Nicolas233004/Projet_elec4/EcoConception/0.Diapo/ACV_Anti_Varroa_ESP32.pptx

ÉCO-CONCEPTION

Système Anti-Varroa
ESP32

Analyse du Cycle de Vie — ReCiPe 2016 midpoint (H)

🐝

Sean Bondon · Abdoulaye Baldé · Nicolas Roth · Léandro Euphrasie

## Slide 2

01 · CONTEXTE & OBJECTIFS

Problématique & Objectif du Projet

CONTEXTE

Varroa destructor

Acarien parasite — principal fléau mondial des colonies d'abeilles. Effondrement en 2-3 ans sans traitement.

Limites chimiques

Résistances aux acaricides, contamination du miel et de la cire, toxicité pour l'apiculteur.

Hyperthermie

42 °C pendant 2 h — seuil létal du varroa mais supporté par les abeilles. Alternative verte.

🦠

OBJECTIF DU PROJET

Concevoir un dispositif embarqué autonome (ESP32) permettant le traitement thermique anti-varroa, sans produit chimique, utilisable hors-réseau.

⚗️

🎯 Cible thermique

⏱ 2 h / cycle · ≥ 90 % mortalité varroa · 0 produit chimique

42°C

50°C max

🌡️

0°C

## Slide 3

02 · UNITÉ FONCTIONNELLE

Unité Fonctionnelle & Flux de Référence

Éliminer ≥ 90 % des varroas dans une ruche en bois, en maintenant 42 °C pendant 2 h, à raison de 12 traitements/an pour un rucher de 5 ruches, avec un équipement conçu pour durer 5 ans.

42°C

température cible

Seuil létal varroa

2 h

par cycle

Durée traitement

300

cycles / 5 ans

Durée de vie

600 h

chauffe active

Énergie totale

3 axes prioritaires d'éco-conception

Résistance mécanique

≥ 300 manipulations

🔩

Efficience énergétique

600 h de chauffe

⚡

Durée de vie 5 ans

Éviter le renouvellement

♻️

## Slide 4

03 · SCHÉMA BLOC & INVENTAIRE

Architecture ESP32 — Inventaire Ecoconception

DS18B20 ×3

Capteurs T° — OneWire
Pins 15/16/17

Ventilateurs ×2

PWM 200 — Pins 2/4
Régulation airflow

🌡️

ESP32

80 MHz · Wi-Fi AP
FreeRTOS · EEPROM

💨

Résistances ×2

Éléments chauffants
Pins 12/13

Interface Web

AP Wi-Fi SEAN_BONDON
IP 192.168.1.15

🔥

📡

⚠ Sécurité : consigne bornée 10–50 °C · Isolation tâches web / PID via FreeRTOS · Watchdog Wi-Fi (restart si aucun client > 30 s)

## Slide 5

04 · RELEVÉ DES IMPACTS ACV

Résultats ReCiPe 2016 — Points Chauds

Toxicité humaine
non-cancérigène

109,97

kg 1,4-DCB-Eq

Composants électroniques (ESP32, PCB) — métaux lourds

Phase dominante :

Écotoxicité
terrestre

65,11

kg 1,4-DCB-Eq

Extraction minière (Cu, Sn, Au) pour l'électronique

Changement
climatique

14,22

kg CO₂-Eq

Production d'énergie électrique — 600 h de chauffe

#1

#2

#3

Fabrication des composants électroniques > Phase d'utilisation énergétique

→ 18 catégories analysées (OpenLCA) — tableau complet disponible en annexe

## Slide 6

05 · DISCUSSION & AXES D'ÉCO-CONCEPTION

Alternatives & Leviers d'Amélioration

PHYSIQUE

Réduire l'électronique

Simplifier le BOM, composants certifiés EPEAT/TCO, réduire le nombre de PCB — cible l'hotspot principal.

PHYSIQUE

Alimentation solaire

Panneau PV pour la phase d'utilisation (600 h) — réduit l'empreinte CO₂ de la chauffe de ~70 %.

USAGE

Régulation PID

Remplacer le Tout-ou-Rien par un vrai PID : moins de dépassements, durée de chauffe réduite, meilleure efficacité biologique.

📦

☀️

⚙️

PHYSIQUE

Boîtier IP65 modulaire

Résistance humidité/abeilles, remplacement des éléments chauffants seuls, ≥ 300 manipulations garanties.

🔧

USAGE

Fin de vie & DEEE

Prévoir le démontage des cartes, matériaux recyclables pour le boîtier, passeport produit documenté.

♻️

ANALYSE

ACV complète

Ajouter la phase fin de vie + transport. Comparer avec Apivar chimique sur 5 ans pour quantifier le gain.

📊

## Slide 7

CONCLUSION

✓

Projet pertinent

Alternative chimio-free, fonctionnel et autonome

PRIORITÉS D'ACTION

→ Simplifier l'électronique + composants certifiés

→ Alimenter en énergie renouvelable (solaire)

→ ACV complète (fin de vie + transport)

→ Comparer avec traitement chimique Apivar / 5 ans

✓

UF bien définie

300 cycles / 600 h sur 5 ans — périmètre clair

⚠

Phase critique identifiée

Fabrication composants = principal hotspot

⚠

Toxicité dominante

109,97 kg 1,4-DCB-Eq + 65 kg écotox. terrestre

🐝

Questions ?

Méthode : ReCiPe 2016 v1.03 midpoint (H) · Outil : OpenLCA · Système : ESP32 complet
