Nicolas233004/Projet_elec4/EcoConception/0.Diapo/Ecoconception_Varroa_ACV.pptx

Éco-Conception

Système de Chauffage Anti-Varroa
par Hyperthermie

Basé sur ESP32 • Régulation thermique autonome • Apiculture durable

Analyse du Cycle de Vie — Simulation OpenLCA | ReCiPe 2016 v1.03 midpoint (H)

## Slide 2

Plan de la Présentation

Contexte & Problématique

Le Varroa destructor et l'alternative thermique

01

Résultats ACV — Impacts

18 catégories d'impact — ReCiPe 2016

04

Description du Projet

Architecture matérielle et logicielle ESP32

02

Analyse des Points Chauds

Catégories dominantes et leviers

05

Unité Fonctionnelle (UF)

Définition et flux de référence ACV

03

Axes d'Éco-conception

Recommandations et perspectives

06

## Slide 3

Contexte & Problématique

Le Varroa destructor

Acarien parasite de l'abeille mellifère — principale menace mondiale des colonies. Sans traitement, la colonie s'effondre en 2 à 3 ans.

En chiffres

42°C

température cible

Seuil létal du varroa

2h

par traitement

Durée d'un cycle

Les limites des traitements chimiques

Résistance croissante aux acaricides, contamination du miel et de la cire, impact sur la santé des abeilles et de l'apiculteur.

≥ 90%

efficacité visée

Mortalité du varroa

0

produit chimique

Alternative verte

L'alternative : l'hyperthermie

Traiter les abeilles à 42 °C pendant 2 h tue le varroa sans produit chimique, car les abeilles supportent cette température contrairement au parasite.

Objectif : concevoir un dispositif embarqué autonome permettant ce traitement thermique pour un usage en extérieur (hors réseau).

## Slide 4

Description du Projet — Architecture ESP32

Matériel (Hardware)

ESP32 (80 MHz, Wi-Fi AP)

Logiciel (Software)

Tout-ou-Rien ±0,5 °C (PID prévu)

Microcontrôleur

Régulation

3 bus OneWire DS18B20 (Pins 15/16/17)

FreeRTOS — PIDTask sur cœur 1 (50 ms)

Multitâche

Capteurs T°

Consigne sauvegardée EEPROM (défaut 35°C)

2 éléments chauffants (Pins 12/13)

Résistances

Mémoire

Point d'accès Wi-Fi "SEAN_BONDON" — IP fixe 192.168.1.15

Interface Web

2 ventilateurs PWM=200 (Pins 2/4)

Ventilateurs

Redémarrage Wi-Fi si aucun client >30 s

Watchdog réseau

⚠ Limite de sécurité : consigne bornée entre 10 °C et 50 °C — sécurité thermique isolée des tâches web par FreeRTOS

## Slide 5

Unité Fonctionnelle & Flux de Référence

Éliminer ≥ 90 % des varroas dans une ruche Dadant 10 cadres en bois, en maintenant 42 °C pendant 2 h,
à raison de 12 traitements/an pour un rucher de 5 ruches, avec un équipement conçu pour durer 5 ans.

Unité Fonctionnelle :

🎯 Fonction

Éradiquer le varroa par hyperthermie tout en préservant la colonie

⏱ Durée / fréquence

2 h par cycle — 12 traitements/an — 5 ruches

📊 Performance

≥ 90 % de mortalité varroa — maintien continu à 42 °C

3 Axes prioritaires d'éco-conception

📅 Durée de vie

5 ans = 300 cycles = 600 heures de chauffe active

Résistance mécanique

≥ 300 manipulations

Efficience énergétique

600 h de chauffe

Durée de vie 5 ans

Éviter le renouvellement

## Slide 6

Résultats ACV — Impacts par Catégorie (ReCiPe 2016 midpoint H)

Système : Projet complet | Unité : 1 kg | Méthode : ReCiPe 2016 v1.03, midpoint (H)

## Slide 7

Analyse des Points Chauds

Les 3 catégories les plus préoccupantes

Toxicité humaine non-cancérigène

109,97

kg 1,4-DCB-Eq

Valeur dominante. Liée à la production des composants électroniques (ESP32, résistances, PCB) dont la fabrication génère des émissions de métaux lourds et composés organiques.

Écotoxicité terrestre

65,11

kg 1,4-DCB-Eq

Impact principalement associé à l'extraction minière des métaux (cuivre, étain, or) nécessaires à l'électronique embarquée.

Changement climatique

14,22

kg CO2-Eq

Émissions de GES dues à la production d'énergie électrique lors de la phase d'utilisation (600 h de chauffe active sur 5 ans).

Phase dominante : fabrication des composants électroniques > phase d'utilisation énergétique

## Slide 8

Tableau Complet des Impacts — OpenLCA

Catégorie d'impact | Unité de référence | Résultat
Acidification : terrestre | kg SO2-Eq | 0,0694
Changement climatique | kg CO2-Eq | 14,22
Écotoxicité : eau douce | kg 1,4-DCB-Eq | 6,63
Écotoxicité : marine | kg 1,4-DCB-Eq | 8,76
Écotoxicité : terrestre | kg 1,4-DCB-Eq | 65,11
Énergie : non-renouvelable fossile | kg oil-Eq | 3,71
Eutrophisation : eau douce | kg P-Eq | 0,0154
Eutrophisation : marine | kg N-Eq | 1,33×10⁻³
Toxicité humaine : cancérigène | kg 1,4-DCB-Eq | 5,10
Toxicité humaine : non-cancérigène | kg 1,4-DCB-Eq | 109,97 ⚠
Rayonnements ionisants | kBq Co-60-Eq | 1,27
Utilisation des terres | m²·a crop-Eq | 1,07
Ressources : métaux/minéraux | kg Cu-Eq | 0,732
Déplétion de la couche d'ozone | kg CFC-11-Eq | 6,29×10⁻⁶
Formation de particules fines | kg PM2.5-Eq | 0,0338
Formation oxydants photochimiques (santé) | kg NOx-Eq | 0,0450
Formation oxydants photochimiques (éco.) | kg NOx-Eq | 0,0479
Utilisation de l'eau | m³ | 0,110

## Slide 9

Axes d'Éco-Conception & Recommandations

Réduire l'électronique embarquée

Simplifier le BOM (Bill of Materials) : choisir des composants à faible impact de fabrication, opter pour des modules certifiés (EPEAT, TCO). Réduire le nombre de PCB.

01

Fin de vie & circularité

Prévoir le démontage des cartes électroniques pour filière DEEE, choisir des matériaux recyclables pour le boîtier, documenter les matériaux (passeport produit).

04

Optimiser la consommation énergétique

Passage en mode veille profonde entre les cycles, optimisation PID pour éviter les dépassements de 42°C, alimentation solaire envisageable pour usage terrain.

02

Valider le PID thermique

Remplacer la logique Tout-ou-Rien par un véritable PID : évite les dépassements de 42°C, réduit la durée de chauffe et la consommation, améliore l'efficacité biologique.

05

Garantir la durabilité mécanique

Boîtier IP65 résistant à l'humidité/abeilles, composants de qualité industrielle, conception modulaire pour remplacement des éléments chauffants seuls.

03

ACV complète & comparaison

Enrichir le modèle avec la phase de fin de vie et le transport. Comparer avec un traitement chimique Apivar sur 5 ans pour quantifier le gain environnemental.

06

## Slide 10

Conclusion

✓ Projet pertinent

Alternative chimio-free au varroa, fonctionnel et autonome

✓ UF bien définie

300 cycles / 600 h sur 5 ans, 5 ruches — périmètre clair pour ACV

⚠ Phase critique identifiée

Fabrication des composants électroniques = principal hotspot

⚠ Toxicité dominante

109,97 kg 1,4-DCB-Eq (tox. non-cancérigène) et 65 kg (écotox. terrestre)

→ Priorité d'action

Simplifier l'électronique + alimenter en énergie renouvelable

→ Prochaine étape

ACV complète avec fin de vie + comparaison avec traitement chimique

Méthode : ReCiPe 2016 v1.03 midpoint (H) | Outil : OpenLCA | Système : Projet complet ESP32
