Nicolas233004/Projet_elec4/Rapport/0.Groupe/Rapport_Toit_Chauffant_Anti_Varroas.docx

Rapport Technique de Projet

Conception et Réalisation d'un Toit Chauffant

pour Ruche Anti-Varroas

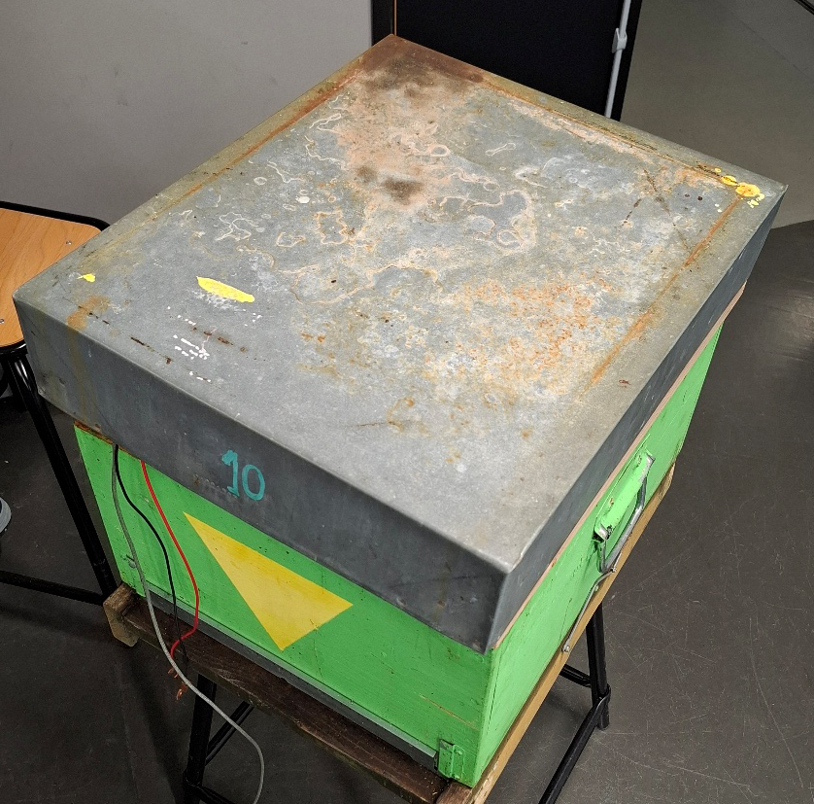
[picture p1: figure]

Équipe Projet | ROTH – EUPHRASIE – BALDE – BONDON
Formation | ELSE 4 – FISA
Période | Octobre 2025 – Avril 2026
Projet n° | 7

# 1. Introduction et Contexte du Projet

## 1.1 Problématique : le Varroa destructor

Le varroa (Varroa destructor) est un acarien parasite originaire d'Asie du Sud-Est qui représente aujourd'hui l'une des menaces les plus sérieuses pour les colonies d'abeilles domestiques à travers le monde. Ce parasite vit aux dépens des abeilles en se fixant sur leur corps et en se nourrissant de leur hémolymphe, affaiblissant ainsi considérablement les individus parasités. Au-delà du prélèvement direct de ressources biologiques, le varroa agit également comme vecteur de nombreux virus pathogènes (virus des ailes déformées, virus de la paralysie aiguë, etc.) qui ont des effets dévastateurs sur les populations apicoles.

Sans traitement, une colonie infestée est condamnée à disparaître en l'espace de 2 à 3 ans. Les méthodes de lutte actuelles incluent les traitements chimiques (acide oxalique, amitraz, fluvalinates), mais ces produits présentent des risques de résistance à long terme, des résidus dans le miel et des effets potentiellement négatifs sur les abeilles elles-mêmes.

Une alternative naturelle et efficace consiste à exploiter la sensibilité thermique différentielle entre les abeilles et les varroas : en portant la température de la ruche à 42°C pendant une durée minimale de 2 heures, il est possible d'éliminer les parasites sans nuire à la colonie. Cette technique, dite de thermothérapie, est l'objet du présent projet.

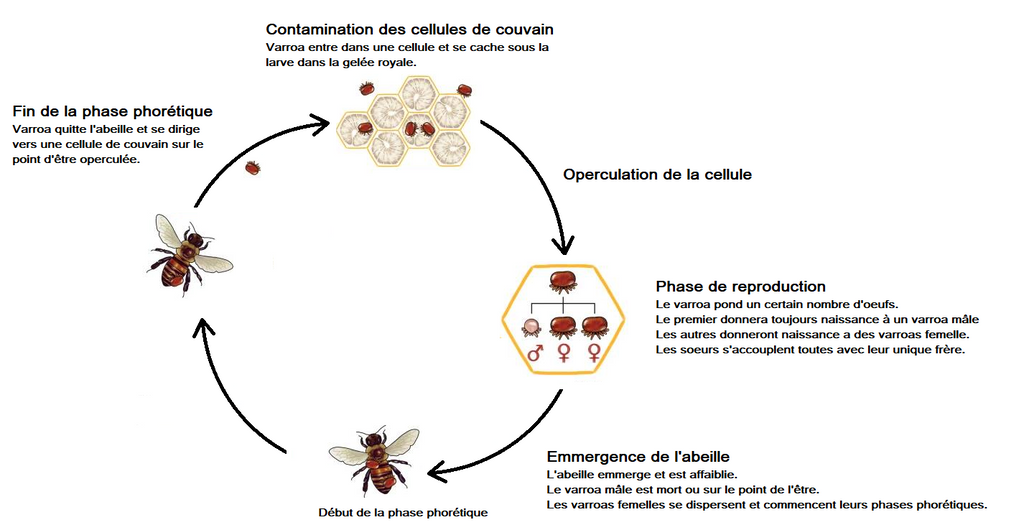
[picture p2: figure]
Varroa, ce que vous DEVEZ savoir. – Apiculture Nicolas D'Amours

## 1.2 Présentation du Projet

Le projet n°7, intitulé « Conception et réalisation d'un toit chauffant pour ruche anti-varroas », s'inscrit dans une initiative plus large visant à développer des ruches connectées capables de se protéger automatiquement des menaces extérieures. L'objectif est de concevoir et réaliser un dispositif électronique embarqué dans le toit d'une ruche, capable de réguler précisément la température interne entre 42°C et 48°C afin d'éliminer les varroas de manière automatique et sans intervention humaine.

Le système repose sur un microcontrôleur ESP32 disposant de deux cœurs de calcul, permettant de gérer simultanément la régulation thermique et l'interface de supervision. Le toit est divisé en deux ailes indépendantes, chacune équipée de résistances chauffantes, de ventilateurs et de capteurs de température, garantissant une homogénéité thermique optimale à l'intérieur de la ruche.

## 1.3 Équipe et Organisation

Le projet a été réalisé par une équipe de quatre étudiants en formation ELSE 4 – FISA, avec une répartition des tâches organisée autour de deux grands domaines :

- Nicolas ROTH – Développement logiciel : code ESP32, régulation, interface web, gestion FreeRTOS.
- Sean BONDON – Partie électronique/mécanique : schémas, PCB, câblage, assemblage de la maquette.
- Leandro EUPHRASIE – Intégration matérielle et écran : soudure, câblage des capteurs, développement de l'afficheur TFT.
- BALD – Conception électronique : schémas sous Eagle, vérification du PCB, simulation sous Micro-Cap.

## 1.4 Cahier des Charges

Les exigences définies en début de projet constituent le cadre de référence de toutes les décisions techniques prises au cours du développement. Elles ont été formalisées dans un CCTP (Cahier des Clauses Techniques Particulières) rédigé dès les premières séances.

Contrainte / Exigence | Description | Statut
Microcontrôleur | Utilisation obligatoire d'un ESP32 | ✔ Respecté
Plage de température | Chauffe entre 42°C et 48°C | ✔ Respecté
Pilotage indépendant | Contrôle des deux ailes du toit de façon autonome | ✔ Respecté
Interface web | Accès à une page de supervision via navigateur | ✔ Respecté
Vérification PCB | Contrôle et refonte si dysfonctionnement | ✔ Effectué
Écran LCD | Affichage local des informations de température | ✔ Réalisé

# 2. Architecture Générale du Système

## 2.1 Vue d'ensemble

Le toit chauffant est un système mécatronique complet intégrant trois grandes dimensions : électronique de puissance, informatique embarquée et interface homme-machine. Son architecture se décompose en deux niveaux physiques superposés dans le toit de la ruche :

- Compartiment inférieur : logement des composants actifs de chauffe et de mesure (résistances, ventilateurs, capteurs DS18B20).
- Compartiment supérieur : logement de la carte de commande à base d'ESP32 et de la carte PCB de puissance.

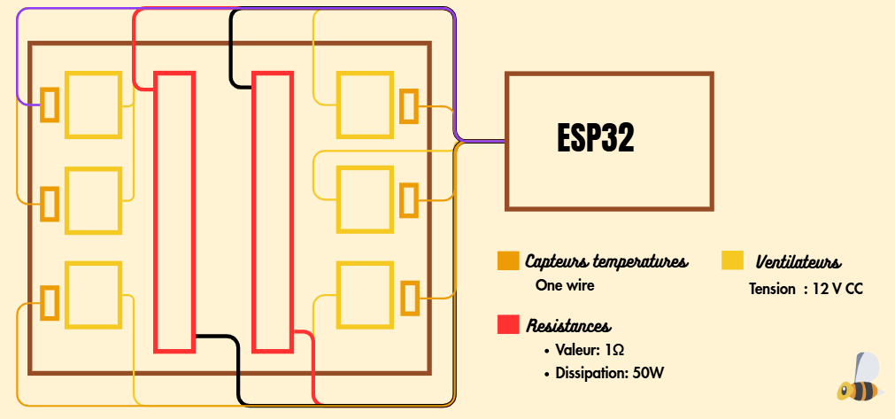
[picture p3: figure]

## 2.2 Architecture Matérielle

### 2.2.1 Le microcontrôleur ESP32

L'ESP32 est un System-on-Chip (SoC) développé par Espressif Systems, doté de deux cœurs Xtensa LX6 cadencés jusqu'à 240 MHz. Pour ce projet, la fréquence a été volontairement abaissée à 80 MHz afin de réduire la consommation de courant et limiter les instabilités d'alimentation. L'ESP32 intègre nativement le Wi-Fi 802.11 b/g/n, le Bluetooth et dispose de nombreuses interfaces périphériques (UART, SPI, I2C, OneWire, PWM, ADC/DAC).

La dualité des cœurs est exploitée via le système d'exploitation temps réel FreeRTOS, permettant d'exécuter simultanément deux tâches indépendantes : la régulation thermique sur le cœur 1 et la gestion du serveur web sur le cœur 0. Cette architecture garantit que les contraintes temps réel de la régulation ne sont pas perturbées par le traitement des requêtes réseau.

Broche ESP32 | Fonction | Composant associé
GPIO 15 (ONE_WIRE_L) | Bus OneWire côté gauche | Capteurs DS18B20 gauche
GPIO 17 (ONE_WIRE_R) | Bus OneWire côté droit | Capteurs DS18B20 droit
GPIO 16 (ONE_WIRE_INFO) | Bus OneWire interne | Capteur intérieur ruche
GPIO 2 (FAN_L) | PWM ventilateur gauche | Ventilateur gauche
GPIO 4 (FAN_R) | PWM ventilateur droit | Ventilateur droit
GPIO 12 (RES_L) | Commande résistance gauche | Résistance chauffante gauche
GPIO 13 (RES_R) | Commande résistance droite | Résistance chauffante droite

### 2.2.2 Capteurs de Température DS18B20

Les capteurs de température utilisés sont des DS18B20 de Dallas Semiconductor, communicant sur un bus OneWire. Ces capteurs à circuit intégré offrent une résolution programmable de 9 à 12 bits, avec une précision de ±0,5°C sur la plage de mesure –10°C à +85°C. Ils sont particulièrement adaptés à ce projet grâce à leur robustesse, leur faible coût et la possibilité d'adresser plusieurs capteurs sur un seul fil de données.

Le projet utilise trois bus OneWire distincts pour isoler les mesures : un pour le côté gauche du toit, un pour le côté droit, et un dédié à la mesure de la température intérieure de la ruche. Cette architecture permet une surveillance indépendante de chaque zone thermique. En cas de défaillance (valeur de –127°C retournée par la bibliothèque), le code déclenche automatiquement une réinitialisation des capteurs pour garantir la continuité de la régulation.

### 2.2.3 Résistances Chauffantes et Ventilateurs

Chaque aile du toit est équipée d'une résistance chauffante alimentée sous 24V (tension nominale de fonctionnement final, après optimisation de l'alimentation). Les résistances sont commandées en ON/OFF par des transistors bipolaires sur la carte PCB. Les ventilateurs, également présents sur chaque aile, assurent la diffusion homogène de la chaleur à l'intérieur du toit, évitant la création de zones thermiques trop importantes.

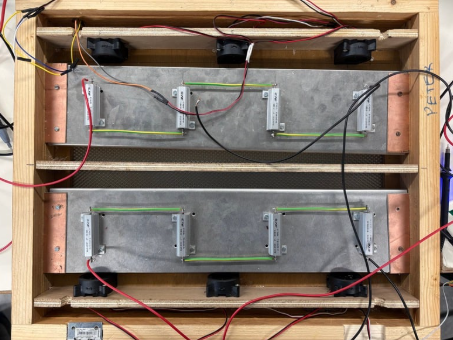
[picture p4: figure]

## 2.3 Architecture Logicielle

### 2.3.1 Organisation du Code Embarqué (ESP32 Principal)

Le firmware de l'ESP32 principal est développé en C++ sous l'environnement PlatformIO (extension Visual Studio Code). Il repose sur les bibliothèques suivantes :

- OneWire + DallasTemperature : communication avec les capteurs DS18B20.
- WiFi + WebServer : gestion du point d'accès Wi-Fi et du serveur HTTP embarqué.
- PID_v1 : algorithme de régulation PID (utilisé en phase initiale de développement).
- EEPROM : sauvegarde persistante de la consigne de température.
- FreeRTOS : système d'exploitation pour la gestion des tâches parallèles.

L'architecture logicielle suit un modèle de concurrence coopérative supervisé par FreeRTOS. La tâche PIDTask, épinglée sur le cœur 1, gère la lecture des capteurs et le contrôle des actionneurs toutes les 500 ms. La boucle principale (loop()), s'exécutant sur le cœur 0, traite les requêtes web toutes les 500 ms également, grâce à un Timer non bloquant.

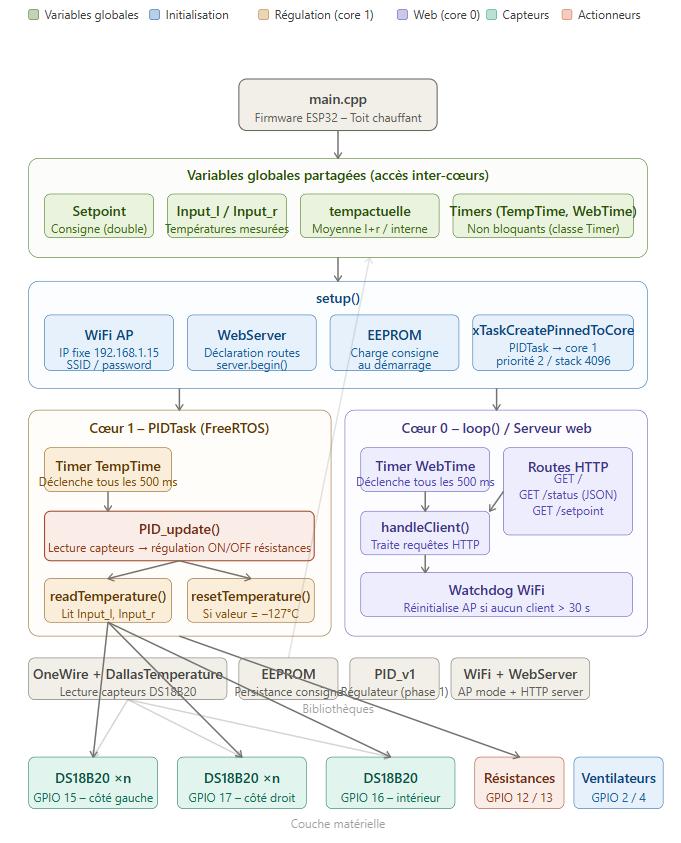
[picture p5: figure]

### 2.3.2 Architecture de l'Écran TFT (ESP32 Secondaire)

Un second ESP32, distinct du module de régulation, est dédié à l'affichage local. Il se connecte en tant que client Wi-Fi au point d'accès créé par l'ESP32 principal et interroge périodiquement la route JSON /status pour récupérer les données de température et de consigne. Ces données sont ensuite affichées sur un écran TFT SPI (contrôleur ST7735, résolution 128×160 pixels) via les bibliothèques TFT_eSPI et ArduinoJson.

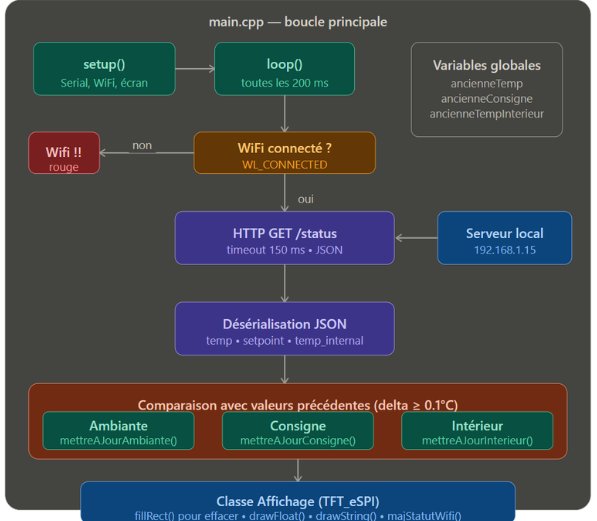
[picture p6: figure]

# 3. Conception et Réalisation du PCB

## 3.1 Analyse du PCB Existant

En début de projet, une carte PCB réalisée par une promotion précédente a été mise à disposition de l'équipe. L'une des premières tâches a consisté à analyser et vérifier le fonctionnement de cette carte avant d'envisager toute modification. Cette analyse a été conduite sous le logiciel Autodesk Eagle, qui a permis de consulter les schémas électriques et d'identifier les différents étages de puissance.

L'examen du PCB a rapidement révélé plusieurs défauts de conception ou d'assemblage hérités de la réalisation précédente : des soudures défectueuses sur les câbles d'alimentation, l'absence de diodes de roue libre sur les circuits de commande des ventilateurs, et des composants (transistors) déjà endommagés lors des premiers tests. Ces problèmes auraient pu provoquer des pannes graves en cas de mise sous tension sans précaution.

## 3.2 Schéma Électronique

Un schéma électrique complet du système a été établi, intégrant les deux ailes indépendantes du toit. Le toit se décompose en deux parties symétriques, chacune comprenant un étage de commande des résistances, un étage de commande des ventilateurs, et le câblage des capteurs de température. La carte PCB gère l'interface de puissance entre l'ESP32 (signaux logiques 3,3V) et les actionneurs (24V pour les résistances, 12V pour les ventilateurs).

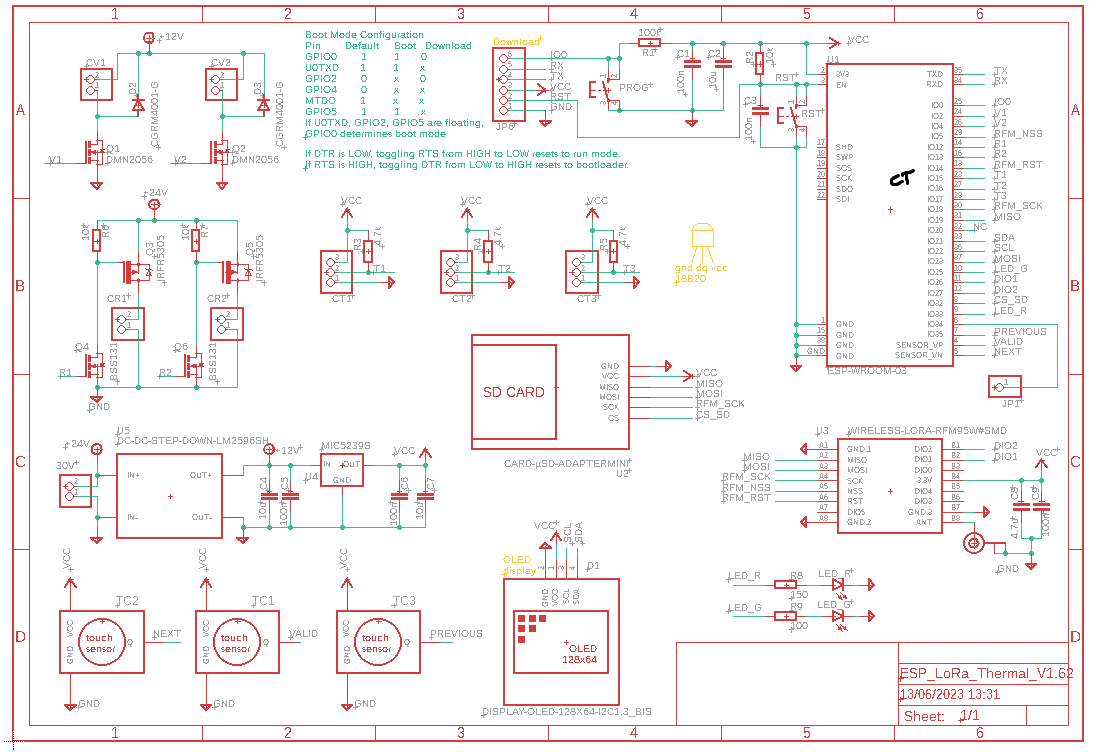
[picture p7: figure]

## 3.3 Composants Critiques et Incidents Matériels

La mise en service du PCB a été jalonnée de nombreux incidents matériels qui ont constitué autant d'occasions d'apprentissage et de diagnostic électronique. Les principaux problèmes rencontrés sont détaillés ci-dessous.

### 3.3.1 Transistors Grillés et Diodes Manquantes

Lors des premiers tests de régulation des ventilateurs par signal PWM, il a été constaté que la commande ne fonctionnait pas correctement. L'analyse à l'oscilloscope a révélé que les transistors bipolaires de commande (en particulier Q3 et Q5) étaient défectueux. La cause principale identifiée était l'absence de diodes de roue libre (ou diodes de protection contre les surtensions inverses) sur les circuits de commande de charges inductives (moteurs de ventilateurs). Sans ces diodes, les pics de tension lors de la commutation (back-EMF) ont détruit les transistors lors des premiers essais.

La solution a consisté à remplacer les transistors défectueux et à souder les diodes de protection manquantes. Un incident supplémentaire s'est produit lors de cette intervention : le pad de soudure de CR1 a été arraché lors du dessoudage. La réparation a été effectuée en connectant directement le fil de remplacement sur une borne accessible du transistor Q3, évitant ainsi de devoir reconcevoir la carte.

INCIDENT CRITIQUE – Court-circuit initial : En séance 4 et 5, un comportement ressemblant à un court-circuit a été détecté. Après analyse, il s'est avéré que les résistances chauffantes consommaient un courant supérieur à la limite réglée sur l'alimentation de laboratoire, provoquant sa mise en protection. Ce n'était donc pas un défaut de la carte, mais un problème de dimensionnement de la source d'alimentation utilisée pour les tests.

### 3.3.2 Composants Q5 et R6 Défectueux

En séance 12, un problème plus grave a été identifié : il était impossible de couper les résistances chauffantes via le code. L'investigation électronique a mis en évidence la défaillance du transistor Q5 et de la résistance R6, éléments-clés du circuit de commande des résistances. Ces composants ont été remplacés, et le montage du convertisseur de tension a été rendu amovible pour faciliter les futures interventions et mesures à l'oscilloscope.

## 3.4 Câblage et Assemblage Mécanique

Le câblage de l'ensemble du système a nécessité un travail minutieux de soudure, de repérage des fils et d'organisation physique des connexions. Les capteurs DS18B20 ont été soudés avec des gaines thermorétractables pour assurer l'isolation électrique et la tenue mécanique des jonctions. Les résistances chauffantes ont nécessité l'allongement de leurs fils de raccordement pour permettre un passage propre entre les deux compartiments du toit.

Des trous ont été percés dans la paroi supérieure du toit au FabLab pour organiser le passage des câbles. Des charnières ont été ajoutées sur la maquette pour faciliter l'accès aux composants lors des interventions, évitant ainsi de devoir dessouder ou débrancher l'ensemble du câblage à chaque ouverture. Enfin, un cache-câbles en bois a été réalisé pour maintenir les fils en ordre et permettre une fermeture propre du toit.

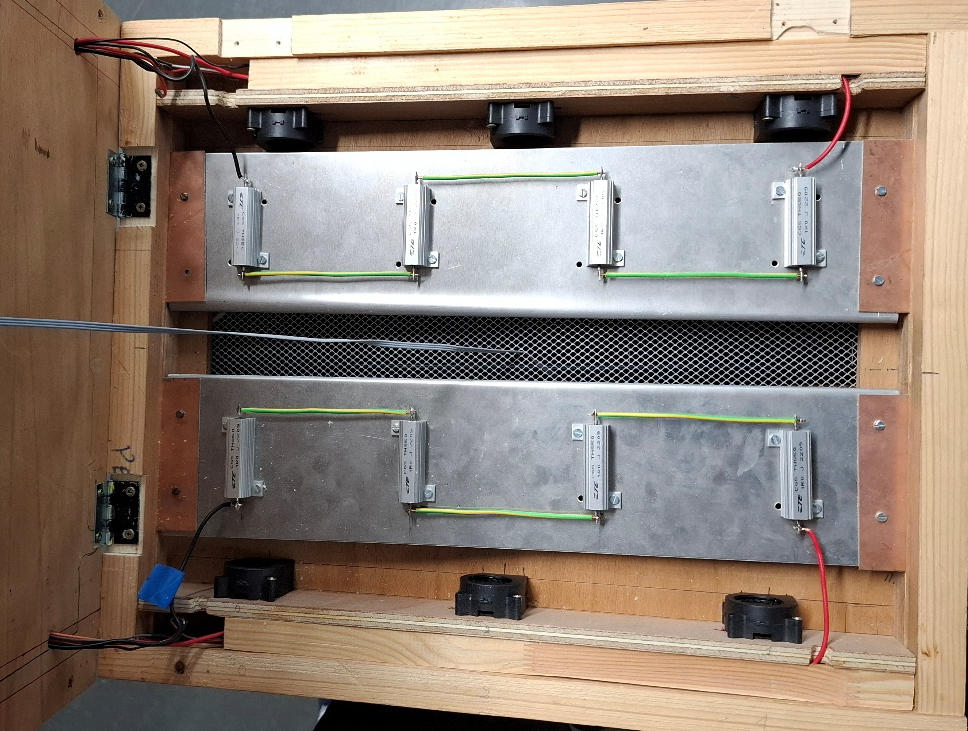
[picture p8: figure]

## 3.5 Simulation sous Micro-Cap 12

En parallèle des travaux matériels, une tentative de simulation du schéma électronique a été réalisée sous le logiciel Micro-Cap 12 (simulateur SPICE). Cette démarche visait à valider le comportement des circuits avant leur mise en œuvre physique. Cependant, les limitations du logiciel (impossibilité d'intégrer certains composants spécifiques comme les moteurs électriques) ont restreint la portée de la simulation, qui a néanmoins permis de vérifier les étages de commande transistorisés.

# 4. Développement Logiciel Embarqué

## 4.1 Environnement de Développement

L'ensemble du développement logiciel a été réalisé sous Visual Studio Code avec l'extension PlatformIO, remplaçant l'IDE Arduino classique. PlatformIO offre une gestion avancée des dépendances de bibliothèques, une meilleure organisation des projets multi-fichiers, et une intégration native avec les outils de compilation pour ESP32. La transition vers cet environnement a nécessité une reconfiguration complète du projet en début de travaux.

## 4.2 Tests Unitaires

Avant l'intégration complète du système, une série de tests unitaires a été réalisée pour valider chaque sous-ensemble indépendamment. Cette approche méthodique, décrite dans le CCTP, a permis d'identifier les défauts matériels au plus tôt et de garantir que chaque composant répondait aux spécifications avant son intégration dans le système global.

Test Unitaire | Objectif | Résultat
1. Pilotage des ventilateurs | Commande PWM indépendante de chaque ventilateur | ✔ Concluant (après réparation transistors)
2. Pilotage des résistances | Commande ON/OFF des résistances chauffantes | ✔ Concluant (après remplacement Q5/R6)
3. Lecture des capteurs DS18B20 | Détection et lecture des 6 capteurs | ✔ Concluant dès la séance 1
4. Pilotage indépendant des ailes | Contrôle séparé côté gauche et côté droit | ✔ Concluant
5. Création page web | Accessibilité du serveur via navigateur | ✔ Concluant
6. Intégration écran LCD/TFT | Affichage température sur écran local | ✔ Concluant (séances 14-15)
7. Assemblage complet | Fonctionnement cohérent de l'ensemble | ✔ Concluant (séance 17)

## 4.3 Algorithme de Régulation Thermique

### 4.3.1 Phase 1 : Régulation PID

Dans un premier temps, une régulation PID (Proportionnelle–Intégrale–Dérivée) a été implémentée à l'aide de la bibliothèque PID_v1. Ce type de régulation permet d'approcher progressivement la consigne sans dépassement excessif (overshoot), grâce au calcul d'une commande basée sur l'erreur courante (terme P), l'accumulation historique des erreurs (terme I) et la vitesse de variation de l'erreur (terme D). L'interface web incluait initialement une page administrateur dédiée au réglage des coefficients Kp, Ki et Kd en temps réel.

### 4.3.2 Phase 2 : Passage à la Régulation Tout-ou-Rien

Face aux problèmes de stabilité de l'ESP32 (resets intempestifs liés à la charge du Wi-Fi et du code), la régulation PID a été temporairement remplacée par une loi de commande tout-ou-rien avec hystérésis. Le principe est simple : si la température mesurée est inférieure à (consigne – 0,5°C), la résistance chauffante est mise sous tension (ON) ; sinon, elle est coupée (OFF). Ce seuil de 0,5°C (défini par la constante SEUIL dans le code) évite les oscillations rapides qui pourraient endommager les actionneurs.

Extrait du code de régulation (fonction PID_update) : if (Input_r < (Setpoint - SEUIL)) digitalWrite(RES_PIN_L, HIGH); else digitalWrite(RES_PIN_L, LOW); if (Input_l < (Setpoint - SEUIL)) digitalWrite(RES_PIN_R, HIGH); else digitalWrite(RES_PIN_R, LOW);

Cette approche, bien que moins précise qu'un PID, s'est révélée plus robuste dans les conditions d'utilisation réelles. La plage de température cible (42°C–48°C) offre une marge suffisante pour qu'une régulation tout-ou-rien soit efficace pour l'application anti-varroa.

## 4.4 Gestion du Multitâche avec FreeRTOS

L'exploitation des deux cœurs de l'ESP32 via FreeRTOS constitue l'une des innovations architecturales majeures du projet. La tâche PIDTask est créée et épinglée sur le cœur 1 avec une priorité de niveau 2, assurant que la régulation thermique est traitée en temps réel sans être interrompue par les activités réseau. Le cœur 0, géré par la boucle Arduino standard, prend en charge le serveur web HTTP.

Les timers non bloquants (classe Timer) permettent de cadencer les différentes activités sans utiliser de delay() bloquants : la lecture des capteurs est effectuée toutes les 500 ms, la gestion des requêtes web toutes les 500 ms également. Un mécanisme de watchdog logiciel surveille la présence de clients connectés au point d'accès ; en l'absence de connexion pendant plus de 30 secondes, le Wi-Fi est réinitialisé automatiquement pour maintenir la disponibilité du service.

## 4.5 Persistance des Données en EEPROM

L'une des améliorations de robustesse apportées en fin de projet concerne la sauvegarde de la consigne de température dans la mémoire EEPROM de l'ESP32. Avant cette modification, tout reset de la carte entraînait la perte de la consigne, forçant l'utilisateur à la ressaisir manuellement. Désormais, la consigne est sauvegardée à chaque modification via la route /setpoint, et rechargée automatiquement au démarrage. Un contrôle de validité (vérification que la valeur est dans la plage 10°C–50°C) permet de détecter une EEPROM non initialisée et d'appliquer la valeur par défaut de 35°C.

## 4.6 Gestion des Erreurs de Capteurs

Un mécanisme de détection et de correction des erreurs de lecture des capteurs DS18B20 a été intégré. Lorsque la bibliothèque DallasTemperature retourne la valeur –127°C (code d'erreur standard OneWire indiquant un problème de communication), la fonction resetTemperature() est appelée automatiquement pour réinitialiser les trois bus OneWire. Cette sécurité est particulièrement importante dans le contexte des resets ESP32, qui peuvent corrompre l'état du bus OneWire et provoquer des lectures erronées persistantes.

# 5. Interface de Supervision

## 5.1 Serveur Web Embarqué

### 5.1.1 Mode Point d'Accès Wi-Fi

L'ESP32 fonctionne en mode Access Point (AP), créant son propre réseau Wi-Fi auquel l'utilisateur peut se connecter directement depuis un smartphone, une tablette ou un ordinateur portable, sans nécessiter d'infrastructure réseau externe (box Internet, routeur). Cette conception rend le système totalement autonome et utilisable sur le terrain, directement au rucher.

Le réseau Wi-Fi est configuré avec l'SSID « SEAN_BONDON » et l'adresse IP fixe 192.168.1.15. La configuration de l'IP fixe (via softAPConfig()) garantit que l'adresse d'accès reste constante, quelle que soit la séquence de démarrage. La directive WiFi.setSleep(false) désactive le mode économie d'énergie du module Wi-Fi, qui était responsable d'instabilités de connexion lors des tests initiaux.

### 5.1.2 Routes HTTP

Le serveur web expose trois routes HTTP accessibles depuis n'importe quel navigateur :

Route | Méthode | Description
GET / | HTTP GET | Retourne la page HTML statique de supervision
GET /status | HTTP GET | Retourne un objet JSON avec les données temps réel
GET /setpoint?value=X | HTTP GET | Modifie la consigne de température (10°C ≤ X ≤ 50°C)

La route /status retourne une structure JSON contenant la température actuelle (moyenne des deux côtés), la température intérieure de la ruche, la consigne en cours, et les valeurs intermédiaires des capteurs et sorties PID. Ces données sont rafraîchies automatiquement toutes les 2 secondes par la page web via une requête fetch() JavaScript asynchrone, permettant un suivi en quasi-temps réel sans rechargement de page.

### 5.1.3 Interface Utilisateur Web

La page web est stockée en mémoire Flash de l'ESP32 (déclarée avec le qualificateur PROGMEM) pour minimiser l'utilisation de la mémoire RAM. Elle présente de manière claire la température de régulation, la température intérieure de la ruche et la consigne actuelle. Un formulaire permet à l'utilisateur de saisir une nouvelle consigne et de l'appliquer immédiatement. Un message de confirmation indique si la modification a été prise en compte avec succès.

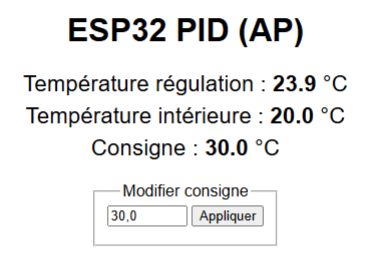
[picture p9: figure]

## 5.2 Afficheur TFT Local

### 5.2.1 Matériel utilisé

Un écran TFT SPI de 128×160 pixels, basé sur le contrôleur ST7735 (remplaçant l'ILI9486 initial perdu lors d'un incident d'alimentation), a été intégré à la maquette. Cet écran est piloté par un second ESP32 dédié, connecté au point d'accès principal. Le choix d'un ESP32 dédié à l'affichage permet de ne pas alourdir le code de régulation et d'éviter les conflits de ressources entre le bus SPI de l'écran et les autres périphériques.

### 5.2.2 Développement de l'Interface

L'interface graphique sur l'écran TFT a été développée en C++ avec la bibliothèque TFT_eSPI. L'interface affiche en temps réel trois informations clés : la température ambiante (mesurée par les capteurs du toit), la température intérieure de la ruche et la consigne de régulation en vigueur. Un code couleur intuitif différencie les informations : la température actuelle s'affiche en orange, la consigne en vert.

Pour éviter les scintillements d'affichage lors des mises à jour, une technique de rafraîchissement sélectif a été implémentée : seules les zones de l'écran contenant des valeurs numériques sont effacées et réécrites, en utilisant la fonction setTextPadding() pour masquer les anciens chiffres sans redessiner entièrement l'écran. La mise à jour n'est déclenchée que si la nouvelle valeur diffère d'au moins 0,1°C de la valeur affichée précédemment (seuil anti-bruit).

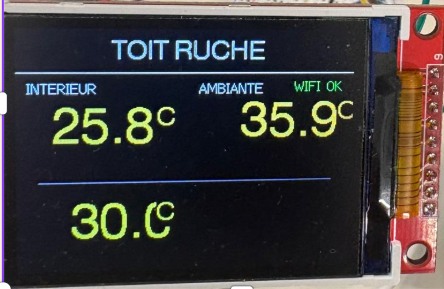
[picture p10: figure]

### 5.2.3 Problèmes Rencontrés et Solutions

L'intégration de l'écran TFT a été l'une des parties les plus complexes du projet, marquée par une succession d'incidents matériels et logiciels.

Le premier écran utilisé (ILI9486) a été détruit lors d'une surtension accidentelle (23V appliqués au lieu des 5V requis lors d'une mauvaise manipulation du générateur de tension en laboratoire). Le second écran (ST7735, 3,3V) a d'abord présenté un écran blanc sans affichage, causé par un branchement incorrect du signal DC sur le GPIO 2 (broche de strapping de l'ESP32, utilisée lors du démarrage). Le déplacement du signal DC vers le GPIO 21 a immédiatement résolu le problème, validant l'ensemble de la chaîne d'affichage.

# 6. Problèmes Rencontrés et Solutions Apportées

La réalisation de ce projet a été marquée par de nombreux obstacles techniques, tant matériels que logiciels. Cette section présente de manière synthétique les principaux problèmes rencontrés, leur diagnostic et les solutions mises en œuvre. La capacité de l'équipe à faire face à ces difficultés de manière méthodique constitue l'un des enseignements majeurs du projet.

## 6.1 Problèmes Matériels

Problème | Cause identifiée | Solution apportée
Tension résiduelle à l'état LOW sur les résistances | Absence de charge lors du test à vide | Test avec charge connectée
Signal PWM non transmis aux résistances | Faux contact sur les câbles de liaison | Dessoudage et ressoudage des fils
Transistors grillés (Q3, Q5) | Absence de diodes de roue libre sur charges inductives | Remplacement transistors + ajout diodes de protection
Pad arraché sur CR1 | Mauvaise qualité de la soudure d'origine | Connexion directe sur borne du transistor Q3
Résistance R6 défectueuse | Composant défaillant | Remplacement de la résistance R6
Écran TFT ILI9486 détruit | Surtension accidentelle (23V) | Remplacement par un écran ST7735 3,3V
Écran blanc (white screen) | Branchement DC sur GPIO 2 (strapping pin) | Déplacement du signal DC sur GPIO 21

## 6.2 Problème Majeur : Reset Intempestifs de l'ESP32

Le problème le plus persistant et le plus difficile à résoudre du projet est apparu lors de l'intégration complète du système : l'ESP32 redémarrait de manière aléatoire, parfois toutes les quelques minutes, rendant le système inutilisable en conditions réelles. Ce problème a mobilisé l'équipe pendant plusieurs séances (séances 9, 13, 14-15 et 16) et a nécessité une approche de débogage progressive.

### 6.2.1 Diagnostic

Plusieurs hypothèses ont été successivement testées pour identifier la cause des resets :

- Watchdog timer (WDT) : déclenchement si une tâche monopolise le CPU trop longtemps sans yield.
- Stack overflow : dépassement de la taille de pile allouée à une tâche FreeRTOS.
- Accès concurrents : deux cœurs accédant simultanément à des données partagées sans protection.
- Consommation de courant : pic de consommation lors de l'activation du Wi-Fi et des résistances dépassant la capacité de l'alimentation.

Après investigation, la cause principale identifiée est la consommation élevée du module Wi-Fi de l'ESP32, provoquant des chutes de tension sur l'alimentation 3,3V qui déclenchent le circuit de reset de la puce. L'ajout d'un condensateur de filtrage plus grand (remplacement de C1) n'a pas suffi à résoudre le problème.

### 6.2.2 Solutions Mises en Œuvre

- Réduction de la fréquence CPU de 240 MHz à 80 MHz (setCpuFrequencyMhz(80)) pour diminuer la consommation globale.
- Désactivation du power-save Wi-Fi (WiFi.setSleep(false)) pour éviter les pics de consommation lors du réveil du module.
- Simplification du code : suppression de la page admin, des paramètres PID réglables, réduction de la mémoire utilisée.
- Passage à une alimentation 24V plus puissante, capable de fournir un courant suffisant pour l'ensemble du système.
- Déplacement de la tâche de régulation sur le cœur 1 pour réduire la charge du cœur 0 (Wi-Fi).
- Sauvegarde de la consigne en EEPROM pour récupérer automatiquement l'état après un reset.
- Ajout d'un mécanisme de réinitialisation automatique du Wi-Fi après 30 secondes sans client connecté.

Résultat : Ces mesures cumulées ont significativement réduit la fréquence des resets, rendant le système suffisamment stable pour une démonstration fonctionnelle. Cependant, une solution définitive (alimentation dédiée à l'ESP32 séparée de la puissance des résistances) reste à mettre en œuvre pour un déploiement réel.

## 6.3 Problèmes Logiciels

Problème logiciel | Cause | Solution
Bibliothèques manquantes après suppression accidentelle | Fichiers essentiels effacés | Réinstallation complète des bibliothèques PlatformIO
Migration Arduino IDE → PlatformIO | Incompatibilité de configuration | Reconfiguration complète du projet
Consigne perdue après reset | Stockage uniquement en RAM | Sauvegarde/chargement en EEPROM
Lecture capteur –127°C persistante | Bus OneWire corrompu après reset | Réinitialisation automatique des capteurs si –127 détecté
Scintillement de l'écran TFT | Rafraîchissement complet de l'écran | Rafraîchissement sélectif avec setTextPadding()

# 7. Tests, Validation et Résultats

## 7.1 Tests de l'Interface de Supervision

L'interface web a été testée depuis différents terminaux (smartphones Android et iOS, ordinateurs portables) pour valider sa compatibilité navigateur et sa réactivité. Le rafraîchissement automatique des données toutes les 2 secondes a été vérifié, ainsi que la prise en compte des modifications de consigne. La persistance de la consigne après reset a également été vérifiée : en coupant et rallumant l'alimentation de l'ESP32, la consigne précédemment saisie est bien restaurée.

L'afficheur TFT a été validé en conditions opérationnelles, connecté au point d'accès de l'ESP32 principal à une distance de plusieurs mètres. Les températures affichées correspondent aux valeurs de référence mesurées indépendamment. Le temps de latence entre la mesure physique et l'affichage sur l'écran est inférieur à 1 seconde dans des conditions de connexion Wi-Fi normales.

## 7.2 Bilan de Conformité au CCTP

Exigence CCTP | Résultat obtenu | Conformité
Pilotage ventilateurs indépendant | Ventilateurs gauche et droit commandés séparément via PWM | ✔ Conforme
Pilotage résistances indépendant | Résistances ON/OFF indépendantes par aile | ✔ Conforme
Lecture capteurs température | 6 capteurs DS18B20 + 1 interne lus correctement | ✔ Conforme
Régulation entre 42°C et 48°C | Consigne configurable, régulation ON/OFF avec seuil 0,5°C | ✔ Conforme
Accès interface web | Page web accessible à 192.168.1.15 | ✔ Conforme
Écran LCD/TFT | Afficheur TFT 128×160 opérationnel | ✔ Conforme
Deux cœurs ESP32 | Régulation sur core 1, Web sur core 0 via FreeRTOS | ✔ Conforme
Stabilité (reset) | Atténuée mais non totalement résolue | ⚠ Partiel

# 8. Retour d'Expérience et Perspectives

## 8.1 Compétences Développées

Ce projet a permis aux membres de l'équipe de développer et approfondir un large spectre de compétences, aussi bien techniques que transversales.

### 8.1.1 Compétences Techniques

- Programmation C++ embarquée : développement sous PlatformIO, gestion des bibliothèques, architecture multi-tâches avec FreeRTOS.
- Électronique de puissance : dimensionnement des circuits de commande, diagnostic et réparation de composants défectueux (transistors, diodes, résistances).
- Soudure et câblage : techniques de soudure fine sur PCB, utilisation des gaines thermorétractables, organisation du câblage dans un espace contraint.
- Communication sans fil : configuration du mode AP Wi-Fi sur ESP32, développement d'un serveur HTTP embarqué, protocole JSON pour l'échange de données.
- Interfaces homme-machine : développement d'une page web responsive, programmation d'un afficheur TFT via SPI.
- Débogage système : utilisation de l'oscilloscope, du multimètre, des logs série pour identifier et corriger des pannes complexes.

### 8.1.2 Compétences Transversales

- Gestion de projet : planification des tâches, adaptation en cas de blocage, travail en parallèle sur différents sous-systèmes.
- Documentation technique : rédaction de rapports de séance, maintien d'un historique des incidents et des solutions.
- Travail en équipe : répartition des rôles selon les compétences, entraide (formation à la soudure, débogage collaboratif).
- Utilisation du FabLab : perçage, découpe bois, accès aux équipements de prototypage.

## 8.2 Points d'Amélioration Identifiés

Avec le recul du projet, plusieurs axes d'amélioration ont été identifiés pour une version future du système :

### 8.2.1 Alimentation

Le problème de reset de l'ESP32 lié à l'alimentation est le point critique à résoudre en priorité. La solution recommandée est la mise en place d'une alimentation dédiée et régulée pour l'ESP32 (3,3V avec condensateur de découplage suffisant), totalement indépendante de l'alimentation des résistances chauffantes (24V). Un régulateur à faible bruit (LDO) ou un convertisseur DC-DC bien filtré permettrait d'isoler les perturbations induites par la commutation des résistances.

### 8.2.2 Régulation PID

La régulation tout-ou-rien actuelle, bien que fonctionnelle pour l'objectif anti-varroa, pourrait être améliorée par la réintroduction d'un PID correctement ajusté une fois le problème d'alimentation résolu. Un PID permettrait une montée en température plus rapide et un maintien plus précis de la consigne, réduisant les oscillations thermiques autour du point de consigne.

### 8.2.3 Interface et Fonctionnalités

- Ajout d'un chronomètre pour mesurer la durée du traitement thermique (minimum 2h requis pour éliminer les varroas).
- Notification automatique (e-mail ou SMS via module GSM) lorsque le traitement est terminé.
- Historisation des températures avec horodatage pour tracer des courbes de chauffe et valider l'efficacité du traitement.
- Réintégration de la page administrateur avec réglage des paramètres PID pour les utilisateurs avancés.
- Ajout d'un boîtier de protection IP54 pour résister aux conditions extérieures du rucher.

## 8.3 Conclusion Générale

Ce projet universitaire de 17 séances a abouti à la réalisation d'un prototype fonctionnel de toit chauffant anti-varroa pour ruche d'abeilles. L'ensemble des exigences du CCTP a été satisfait, à l'exception d'une stabilité électrique parfaite qui nécessiterait une révision de l'architecture d'alimentation.

Le système démontre la faisabilité technique d'une solution de thermothérapie automatisée, autonome et supervisable à distance, accessible à un apiculteur disposant d'un smartphone. L'intégration d'un microcontrôleur ESP32 avec ses deux cœurs, d'une interface web embarquée et d'un afficheur local constitue une architecture solide qui pourrait, après correction des points de fragilité identifiés, être déployée en conditions réelles.

Au-delà des résultats techniques, ce projet a représenté une expérience d'apprentissage riche pour tous les membres de l'équipe, confrontés à des problèmes concrets de conception électronique, de programmation embarquée et de gestion de projet en contexte réel.

# 9. Annexes

## Annexe A – Chronologie du Projet

Séance | Date | Thème principal | Acteurs
1 | 08/10/2025 | Mise en place environnement, tests capteurs DS18B20 | Nicolas
2 | 23/10/2025 | Tests résistances et ventilateurs, code principal + PID | Nicolas / Roth
3 | 10/10/2025 | Développement page web embarquée | Nicolas
4 | 11/10/2025 | Amélioration web (user/admin), court-circuit détecté | Nicolas
5 | 27/11/2025 | Analyse court-circuit, tests PWM, dessoudage/ressoudage | Nicolas / Sean
6 | 28/11/2025 | Tests côté gauche, transistor grillé identifié | Sean / Nicolas
7 | 11/11/2025 | Remplacement transistors + diodes, validation côté gauche | Roth / Sean
8 | – | Schéma électrique, PCB Eagle, câblage résistances | Sean / Leandro
9 | 21/01/2026 | Mode Access Point Wi-Fi, répartition sur 2 cœurs | Nicolas
10 | 03/02/2026 | Début intégration écran TFT ILI9486 | Nicolas / Leandro
11 | 17/02/2026 | Charnières maquette, débogage carte, tests écran | Toute l'équipe
12 | 19/02/2026 | Remplacement Q5/R6, validation contrôle résistances | Nicolas / Sean
13 | 05/03/2026 | Tests globaux maquette, reset ESP32 identifié | Toute l'équipe
14-15 | 17/03/2026 | Stabilisation alimentation, Wi-Fi, simplification code | Nicolas / Leandro
16 | 03/04/2026 | Alimentation 24V, régulation ON/OFF, capteur interne | Toute l'équipe
17 | 10/04/2026 | Finalisation maquette, EEPROM, tests globaux complets | Toute l'équipe

## Annexe B – Bibliothèques Utilisées

Bibliothèque | Version | Rôle
OneWire | – | Communication bus OneWire pour DS18B20
DallasTemperature | – | Lecture des capteurs DS18B20
WiFi (ESP32) | – | Gestion du réseau Wi-Fi en mode AP
WebServer (ESP32) | – | Serveur HTTP embarqué
PID_v1 | – | Algorithme de régulation PID (phase 1)
EEPROM (ESP32) | – | Sauvegarde persistante de la consigne
FreeRTOS | – | Gestion multitâche sur les deux cœurs
TFT_eSPI | – | Pilotage écran TFT SPI ST7735
ArduinoJson | – | Parsing des données JSON sur l'ESP32 écran
HTTPClient (ESP32) | – | Requêtes HTTP client depuis l'ESP32 écran

## Annexe C – Glossaire

Terme | Définition
ESP32 | Microcontrôleur dual-core Wi-Fi/Bluetooth d'Espressif Systems
DS18B20 | Capteur de température numérique sur bus OneWire de Dallas Semiconductor
PWM | Pulse Width Modulation – modulation de largeur d'impulsion pour contrôle de puissance
PID | Proportionnel–Intégral–Dérivé – algorithme de régulation classique en boucle fermée
FreeRTOS | Système d'exploitation temps réel open source pour microcontrôleurs
OneWire | Protocole de communication série sur un seul fil de données
PCB | Printed Circuit Board – carte de circuit imprimé
AP | Access Point – mode Wi-Fi où l'ESP32 crée son propre réseau
EEPROM | Electrically Erasable Programmable ROM – mémoire non volatile reprogrammable
TFT | Thin-Film Transistor – technologie d'écran à cristaux liquides
SPI | Serial Peripheral Interface – bus de communication série synchrone
JSON | JavaScript Object Notation – format léger d'échange de données
Varroa | Varroa destructor – acarien parasite des abeilles domestiques
CCTP | Cahier des Clauses Techniques Particulières – document de spécifications techniques
EEPROM | Mémoire persistante de l'ESP32 utilisée pour sauvegarder la consigne

ROTH – EUPHRASIE – BALDE – BONDON | 1 / 2

Rapport Projet – Toit Chauffant Anti-Varroas | ELSE 4 FISA
