Nicolas233004/Projet_elec4/Rapport/Rapports Abdoulaye/Rapport Séance 13.md

# Rapport de Séance - Abdoulaye Baldé
## Date : 17 mars 2026

Je n'ai pas pu assister aux travaux pratiques du 17 mars 2026 (matin et après-midi) pour des raisons médicales. J'ai informé le professeur et transmis un justificatif à la scolarité.

---

*Abdoulaye Baldé
