Nicolas233004/Projet_elec4/Rapport/Rapports Abdoulaye/Rapport séance 14.md

# Rapport de Séance Personnelle - Abdoulaye
## Date : 3 avril 2026

## Contexte
Séance de reprise après deux absences pour raison médicale. Durant mon absence, les autres membres de l'équipe ont finalisé les corrections matérielles (court-circuit, chute de tension, remplacement de condensateurs et d'un capteur) et ont intégré la partie logicielle dont j'étais responsable. Le système semble désormais fonctionnel.

## Travail effectué

### Constat et état d'avancement
- Les problèmes de la carte ont été résolus par l'équipe.
- Les tests préliminaires indiquent que l'ensemble fonctionne correctement.

### Mes actions personnelles
- J'ai pris connaissance des modifications apportées par l'équipe.
- J'ai exploré l'utilisation de Wokwi en simulation pour tester indépendamment la logique dual-core (LEDs, capteurs virtuels). Cette approche m'a permis de valider le comportement attendu du code en l'absence de matériel.

### Bilan personnel
Bien que je n'aie pas pu participer à la phase finale d'intégration en raison de mon absence, l'essentiel de mon travail (architecture dual-core, gestion des seuils, synchronisation) est présent dans la solution finale. Cette situation me montre l'importance de la continuité dans un projet d'équipe et me motive à rattraper le retard sur les aspects que j'aurais pu approfondir (simulation, documentation).

## Prochaines étapes
- Finaliser ma prise en main des modifications apportées.
- Contribuer à la documentation finale et aux tests de validation.
- Poursuivre l'apprentissage de Wokwi pour les futurs développements.

---

*Abdoulaye Baldé
