Nicolas233004/Projet_elec4/Rapport/Rapports Abdoulaye/Rapport Séance 11.md

# Rapport de Séance Personnelle - Abdoulaye
## Date : 19 février 2026

## Contexte
Cette séance s'est déroulée dans une période d'attente technique, les autres membres du groupe étant encore en train de finaliser les vérifications matérielles suite au remplacement du transistor défaillant. La carte n'était donc pas disponible pour les tests pratiques.

## Déroulement de la Séance

### Revue et Optimisation du Code
J'ai consacré cette séance à une révision approfondie du code dual-core en prévision des prochains tests :

- **Vérification de la cohérence globale** du programme
- **Optimisation des commentaires** pour une meilleure maintenabilité
- **Préparation des modifications** à apporter en fonction des premiers retours matériels

Cette phase de revue, bien que moins visible qu'un test réussi, est essentielle pour garantir la robustesse du code lors de la mise en situation réelle.

### Anticipation des Prochains Tests
J'ai également profité de cette séance pour :
- Lister les points de vérification prioritaires
- Préparer un protocole de test étape par étape
- Identifier les seuils critiques à surveiller

## Problèmes Rencontrés
- **Indisponibilité de la carte** pour les tests pratiques
- **Attente** de la validation matérielle complète par les autres membres

## Acquis de la Séance
- Renforcement de la compréhension globale du code
- Amélioration de la documentation technique
- Préparation méthodique des futures phases de test

## Prochaines Étapes
1. Passage aux tests pratiques dès que le matériel sera disponible
2. Validation du bon fonctionnement des capteurs côté A et B
3. Test de la régulation dual-core en conditions réelles
4. Ajustements du code si nécessaire

---

*Abdoulaye Baldé*
