Nicolas233004/Projet_elec4/Rapport/Rapports Abdoulaye/Rapport Séance 10.md

# Rapport de Séance Personnelle - Abdoulaye
## Date : 17 février 2026

## Contexte
Cette séance devait être consacrée aux premiers tests pratiques du code dual-core sur la carte, mais les problèmes matériels persistent. Un transistor défaillant a été identifié et son remplacement était en cours par les autres membres du groupe. D'autres tests matériels étaient également réalisés en parallèle par l'équipe.

## Déroulement de la Séance

### Révision Approfondie du Code
En attendant la résolution des problèmes matériels et la disponibilité de la carte, j'ai consacré cette séance à une revue complète et méthodique du code dual-core :

- **Vérification de la logique de synchronisation** entre les deux cœurs (variables partagées et drapeau)
- **Optimisation des temporisations** pour garantir une réactivité optimale
- **Validation des seuils de déclenchement** pour les résistances et ventilateurs
- **Ajout de commentaires détaillés** pour faciliter la maintenance future
- **Préparation de scénarios de test** pour valider chaque fonctionnalité dès que le matériel sera disponible

### Anticipation des Tests à Venir
J'ai également préparé un plan de test détaillé pour la prochaine séance, incluant :
- Les vérifications à effectuer sur chaque capteur individuellement
- Les séquences de test pour valider le contrôle des actionneurs
- Les points critiques à surveiller lors du premier démarrage

## Prochaines Étapes
1. **Finalisation des réparations matérielles** (transistor et autres composants)
2. **Tests intensifs du code dual-core** dès que la carte sera opérationnelle
3. **Ajustements** basés sur les résultats des tests
4. **Intégration progressive** des fonctionnalités supplémentaires

---

*Abdoulaye Baldé*
