Nicolas233004/Projet_elec4/Rapport/Rapports Abdoulaye/Rapport Séance 9.md

# Rapport de Séance Personnelle - Abdoulaye
## Date : 3 février 2026

## Contexte
Séance consacrée au diagnostic et à la résolution des problèmes de court-circuit persistants sur la carte électronique, qui bloquent l'avancement des tests logiciels depuis plusieurs semaines.

## Déroulement de la Séance

### Investigations Matérielles Approfondies
Nous avons poursuivi les investigations en utilisant une approche systématique avec deux outils principaux :

- **Multimètre** : pour les tests de continuité, mesures de résistance et vérification des tensions
- **Oscilloscope** : pour analyser les signaux et détecter d'éventuelles anomalies dynamiques

### Résultats des Diagnostics
Grâce à cette méthodologie, nous avons réussi à réduire le problème de court-circuit de moitié. Cependant, la localisation précise reste complexe car :

- Le problème semble se déplacer selon les composants testés
- Certains composants présentent des intermittences dans leur comportement
- Les défauts apparaissent et disparaissent selon les conditions de test

### Travail Collaboratif
J'ai participé activement aux sessions de débogage en alternant entre :
- La manipulation des instruments de mesure
- L'analyse des résultats obtenus
- La discussion des hypothèses avec l'équipe

## Problèmes Rencontrés

### Nature Fluctuante du Problème
- **Localisation changeante** : le défaut semble se manifester sur différents composants à différents moments
- **Intermittence** : le court-circuit apparaît et disparaît, compliquant la répétabilité des tests
- **Complexité du circuit** : la densité des composants rend l'isolation du problème difficile

### Impact sur le Développement
- Impossibilité de procéder aux tests du code dual-core
- Retard significatif dans le calendrier de validation
- Frustration liée à l'incapacité de valider les avancées logicielles

## Prochaines Étapes

### Priorités Immédiates
1. Finaliser l'isolation complète du ou des court-circuits résiduels
2. Remplacer les composants identifiés comme défectueux
3. Procéder à une validation complète de la carte après réparations

### Planification
- Poursuite des investigations lors de la prochaine séance
- Préparation d'un plan de test complet pour valider la stabilité matérielle
- Coordination avec toute l'équipe pour une résolution définitive

## Bilan Personnel
Cette séance a été techniquement exigeante mais formative. Bien que frustré par la persistance des problèmes matériels, je reconnais la valeur des compétences acquises en diagnostic électronique. La réduction du problème de moitié représente un progrès tangible, même s'il reste insuffisant pour reprendre les tests logiciels.
