Nicolas233004/Projet_elec4/Rapport/Rapports Abdoulaye/Rapport Séance 8.md

# Rapport de Séance Personnelle - Abdoulaye
## Date : 21 janvier 2026

## Contexte
Cette séance particulière a été divisée en deux temps : une première partie consacrée aux présentations orales de l'état d'avancement de chaque groupe, suivie d'une reprise normale des travaux de développement.

## Déroulement de la Séance

### Présentation Orale
J'ai présenté à l'ensemble de la promotion notre avancement sur la programmation dual-core de l'ESP32. J'ai notamment présenté :

- L'architecture dual-core exploitant les deux cœurs de l'ESP32
- Le diagramme de flux illustrant la répartition des tâches
- Les avantages concrets en termes de performance et de robustesse
- Les perspectives d'évolution avec l'intégration du contrôle PID

Les retours ont été positifs et ont confirmé la pertinence de notre approche technique.

### Reprise des Travaux
Après la session de présentation, nous avons repris le développement normal du projet. Mon travail s'est concentré sur :

- **Révision approfondie du code dual-core** : vérification de la synchronisation entre les cœurs, optimisation des temporisations, validation de la logique de contrôle
- **Documentation technique** : mise à jour des commentaires et de la documentation du code pour faciliter la maintenance future

## Problèmes Rencontrés
Malgré l'avancement logiciel, les tests pratiques restent impossibles en raison de :

- **Problèmes matériels persistants** sur la carte électronique
- **Indisponibilité du banc de test** complet pour valider l'intégration
- **Dépendance aux corrections** des autres autres membres sur les aspects matériels

## Acquis de la Séance
- Compétences en communication technique
- Expérience en revue de code et optimisation
- Patience et adaptation face aux contraintes matérielles

## Prochaines Étapes
1. Poursuite des corrections matérielles 
2. Tests immédiats dès que le matériel sera disponible

## Bilan Personnel
Cette séance a été l'occasion de valoriser notre travail auprès des autres groupes et de recevoir des retours constructifs. Bien que frustré par l'impossibilité de tester physiquement le code, je reste confiant dans la qualité de la solution développée. L'expérience de présentation technique a été particulièrement enrichissante et m'a permis d'améliorer mes compétences en communication.

La priorité absolue reste la résolution des problèmes matériels pour enfin passer à la phase de validation pratique.
