Nicolas233004/Projet_elec4/Rapport/Leandro/Rapport séance 8.md

## Rapport Séance 8
Date : 20/01/2026
Nom : Leandro Euphrasie
Formation : ELSE 4 – FISA

## 1. Continuation du support visuel
En vu de la soutenance du projets l'objectif de ma seance a etait de finir les slides commencer a la seance precedente.

## 2.Repartition du contenu de la presentation
Durant la seance nous nous sommes mis d'accord sur chacun des points que nous allions presenter pendant la soutenance
## Prochaines étapes
- presentation
