Nicolas233004/Projet_elec4/Rapport/Leandro/Rapport séance 9.md

## Rapport de Séance 9
Date : 21/01/2026
Nom : Leandro Euphrasie
Formation : ELSE 4 – FISA

## 1. Presentation orale 
Pendant cette seance nous sommes passer a l'orale
## 2. Evaluation des autres groupes
Nous avons du evaluer les passages des autres groupes
