Nicolas233004/Projet_elec4/Rapport/Leandro/Rapport Seance 7.md

# Rapport de Séance 7 
**Date :** 11/12/2025  
**Nom :** Leandro Euphrasie  
**Formation :** ELSE 4 – FISA  

## 1. Creation du support visuel
En vu de la soutenance du projets l'objectif de ma seance a etait de commencer a creer les slides. 

## Prochaines étapes
- Continuer le slides
