Nicolas233004/Projet_elec4/Rapport/Rapports Abdoulaye/Rapport Séance 7.md

# Rapport de Séance Personnelle - Abdoulaye
## Date : 11 décembre 2025

## Contexte
Séance consacrée à la poursuite des tests et à la résolution des problèmes matériels persistants sur la maquette de régulation thermique.

## Travail Réalisé

### Diagnostic et Résolution du Problème des Transistors
Lors des tests de ce matin, nous avons identifié un dysfonctionnement au niveau des transistors. Après analyse, nous avons décidé de les retirer et de les remplacer par de nouveaux transistors fonctionnels.

### Participation aux Opérations de Soudage
J'ai participé au rétablissement des connexions électriques critiques pour le contrôle des actionneurs en réalisant les soudures nécessaires.

### Tests des Ventilateurs
Suite au remplacement des transistors, nous avons procédé à une validation progressive du système :
- Test des ventilateurs du premier côté de la maquette : **Fonctionnel**
- Test des ventilateurs du second côté de la maquette : **Fonctionnel**
- Vérification du contrôle individuel de chaque ventilateur

## Prochaines Étapes
Avec les ventilateurs maintenant opérationnels, nous pouvons envisager :
1. Tests complets du système de régulation thermique
2. Implémentation et validation du code dual-core
3. Intégration de la logique de contrôle PID

---

*Abdoulaye Baldé*
