Nicolas233004/Projet_elec4/Rapport/Rapports Abdoulaye/Rapport Séance 6.md

# Rapport de Séance - Abdoulaye
## Date : 28/11/2025

## Contexte
La carte électronique est enfin revenue du fablab après réparation. Cette séance marque notre première tentative de reprise des tests après une longue période d'attente due aux problèmes matériels.

## Déroulement de la Séance

### Tests Partiels sur un Côté de la Ruche
Plutôt que de tester immédiatement le système dual-core complet, nous avons opté pour une approche progressive en simulant un seul côté de la ruche. Cette stratégie nous a permis d'obtenir quelques résultats satisfaisants concernant le fonctionnement des capteurs de température et des résistances chauffantes.

### Problèmes Matériels Persistants
Malgré la réparation au fablab, le problème de court-circuit n'a pas été complètement résolu. Les ventilateurs restent hors service, ce qui limite considérablement nos capacités de test. La persistance de ce problème technique nous a obligés à consacrer une partie importante de la séance à de nouveaux diagnostics.

### Travail de Diagnostic
Nous avons procédé à une série de vérifications systématiques pour tenter d'identifier l'origine exacte du court-circuit affectant les ventilateurs. Cette investigation a impliqué des tests de continuité, l'inspection visuelle des soudures et la vérification des connexions d'alimentation.

### Révision du Code Dual-Core
Pendant les périodes d'indisponibilité du matériel, j'ai profité pour revoir et approfondir ma compréhension du code de gestion des deux cœurs de l'ESP32. Cette révision m'a permis de mieux appréhender les mécanismes de synchronisation et la répartition des tâches entre les cœurs.

## Bilan Technique
Les tests partiels ont confirmé que certains éléments du système fonctionnent correctement, notamment la lecture des capteurs et le contrôle des résistances. Cependant, le problème récurrent des ventilateurs empêche toujours la validation complète du système et l'implémentation du dual-core.

## Perspectives
La priorité absolue reste la résolution définitive du problème des ventilateurs. Une fois cette étape franchie, nous pourrons procéder aux tests complets du système dual-core qui attendent depuis plusieurs séances.

## Conclusion
Cette séance a été marquée par des avancées limitées mais réelles. La patience et la persévérance restent essentielles face aux défis techniques persistants. Je reste confiant dans notre capacité à surmonter ces obstacles pour finaliser le projet.

---
*Abdoulaye Baldé*
