Nicolas233004/Projet_elec4/Rapport/Rapports Abdoulaye/Rapport Séance 5.md

# Rapport de Séance No 5 - Abdoulaye
## Date : 27/11/2025

## Contexte
La séance d'aujourd'hui a été entièrement consacrée à la résolution du problème de court-circuit qui bloque notre avancement depuis plusieurs séances.

## Travail Réalisé
Nous avons effectué diverses manipulations de diagnostic pour tenter d'identifier l'origine du court-circuit. Après plusieurs tentatives infructueuses, nous avons pris la décision de renvoyer le matériel au fablab pour une nouvelle expertise.

La stratégie retenue consiste à :
- Dessouder complètement les fils d'alimentation
- Procéder par étapes en soudant un seul fil à la fois
- Tester systématiquement l'absence de court-circuit avant chaque nouvelle soudure

Cette approche méthodique devrait nous permettre d'isoler progressivement la source du problème.

## Constat
Malgré nos efforts, la journée n'a pas été productive en termes d'avancement technique. L'impossibilité de tester le code dual-core préparé lors des séances précédentes reste une frustration majeure.

## Perspective
En attendant la résolution du problème matériel, je maintiens le code prêt pour les futurs tests. La situation actuelle renforce l'importance d'une validation progressive du matériel avant toute intégration complexe.

## Prochaines Étapes
- Suivi de la réparation au fablab
- Reprise des tests dès le matériel disponible
- Validation pas à pas de chaque connexion

---

*Abdoulaye Baldé*
