Nicolas233004/Projet_elec4/Rapport/Rapports Abdoulaye/Rapport Séance 3.md

# Rapport de Séance
## Date : 04/11/2025

## Objectifs de la Séance
- Comprendre et maîtriser la programmation dual-core de l'ESP32
- Préparer l'intégration du système de lecture température dans une architecture multicœur
- Anticiper les développements futurs en attendant la finalisation du matériel

## Travail Réalisé

### Analyse Technique Approfondie
J'ai consacré cette séance à étudier en profondeur le fonctionnement du dual-core sur l'ESP32, plus particulièrement :
- **Architecture des tâches parallèles** : Compréhension du système FreeRTOS intégré
- **Gestion des ressources partagées** : Variables volatile et mécanismes de synchronisation
- **Répartition optimale des traitements** entre les deux cœurs

### Adaptation du Code Existant
J'ai travaillé sur l'intégration de notre code de lecture des capteurs DS18B20 dans une architecture dual-core :
- **Reprise du code de lecture température** déjà développé
- **Conception d'une architecture** où le cœur 0 gère la lecture et le côté A
- **Définition des responsabilités** du cœur 1 pour le contrôle du côté B

### Résolution des Défis Techniques
- **Synchronisation** entre les deux cœurs pour éviter les conflits
- **Optimisation des délais** de lecture pour une réactivité maximale
- **Préparation du système** de contrôle PID futur

## Acquis Personnels

### Nouvelles Compétences
- Maîtrise de la fonction `xTaskCreatePinnedToCore()` pour le multitâche
- Compréhension des spécificités de la programmation temps réel sur ESP32
- Gestion des variables partagées en environnement multicœur

## Défis Rencontrés

### Défi Principal : Attente Matérielle
Le retard dans la soudure des composants par l'autre binôme m'a empêché de :
- Tester physiquement le code sur la maquette
- Valider les temps de réponse réels
- Ajuster les paramètres de contrôle

## Prochaines Étapes

### Plan d'Action
- Finaliser le code dual-core en attendant que le matériel soit prêt
- Tester le code dès que possible et corriger les erreurs
- Améliorer le code progressivement après les tests

### Perspectives
Une fois le matériel disponible, je pourrai tester le code et voir s'il fonctionne correctement. En cas de problème, je devrai le corriger avant de passer à l'étape suivante.

---

*Abdoulaye Baldé*
