Nicolas233004/Projet_elec4/Code_Maquette/docs/modbus.md

# Modbus
In Modbus communication, data is organized into four primary types, each serving specific purposes and access permissions.
## 🧩 Modbus Data Types Overview
| Data Type | Size | Access | Typical Use Case | Function Code | |
| --- | --- | --- | --- | --- | --- |
| **Coils** | 1 bit | Read/Write | Control outputs (e.g., turning on a relay) | 01 (Read), 05 (Write Single), 15 (Write Multiple) | |
| **Discrete Inputs** | 1 bit | Read-only  | Monitor digital inputs (e.g., switch status) | 02 (Read) | |
| **Input Registers** | 16 bits | Read-only  | Read analog inputs (e.g., sensor data) | 04 (Read) | |
| **Holding Registers** | 16 bits | Read/Write | Store configuration parameters or control analog outputs | 03 (Read), 06 (Write Single), 16 (Write Multiple) |
