Nicolas233004/Projet_elec4/EcoConception/3.Fichier Excel/Toit_chauffant.xlsx

Sheet: Systeme_Global
Activity | Système de Chauffage de Ruche
code | Systeme-Chauffage-Ruche
Exchanges
name | alt-name | amount | unit | database | categories | location | type | uncertainty type | loc | scale | shape | minimum | maximum
Système de Chauffage de Ruche |  | 1 | unit | ESOS-Formation |  | France | production | 0 | (Unknown) | (Unknown) | (Unknown) | (Unknown) | (Unknown)
Carte de régulation |  | 1 | unit | ESOS-Formation |  | GLO | technosphere | 0 | (Unknown) | (Unknown) | (Unknown) | (Unknown) | (Unknown)
Lignes de Capteurs |  | 1 | unit | ESOS-Formation |  | GLO | technosphere | 0 | (Unknown) | (Unknown) | (Unknown) | (Unknown) | (Unknown)
Ligne des Ventilateurs |  | 1 | unit | ESOS-Formation |  | GLO | technosphere | 0 | (Unknown) | (Unknown) | (Unknown) | (Unknown) | (Unknown)
Ligne de Chauffe |  | 1 | unit | ESOS-Formation |  | GLO | technosphere | 0 | (Unknown) | (Unknown) | (Unknown) | (Unknown) | (Unknown)
support |  | 1 | unit | ESOS-Formation |  | GLO | technosphere | 0 | (Unknown) | (Unknown) | (Unknown) | (Unknown) | (Unknown)

Sheet: Carte_regulation
Activity | Carte de régulation
code | Carte-de-regulation
Exchanges
name | alt-name | amount | unit | database | categories | location | type | uncertainty type | loc | scale | shape | minimum | maximum
Carte de régulation |  | 1 | unit | ESOS-Formation |  | GLO | production | 0 | (Unknown) | (Unknown) | (Unknown) | (Unknown) | (Unknown)
market for capacitor, for surface-mounting | 100n (C1 C3 C5 C6 C9) | 5e-05 | kilogram | ecoinvent-391-cutoff | passive-component | GLO | technosphere | 0 | (Unknown) | (Unknown) | (Unknown) | (Unknown) | (Unknown)
market for capacitor, for surface-mounting | 10u (C2 C4 C7) | 3e-05 | kilogram | ecoinvent-391-cutoff | passive-component | GLO | technosphere | 0 | (Unknown) | (Unknown) | (Unknown) | (Unknown) | (Unknown)
market for capacitor, for surface-mounting | 4.7u (C8) | 1e-05 | kilogram | ecoinvent-391-cutoff | passive-component | GLO | technosphere | 0 | (Unknown) | (Unknown) | (Unknown) | (Unknown) | (Unknown)
market for capacitor, for surface-mounting | PINHD-1X2 (CR1 CR2 CV1 CV2 UNK30V0) | 5e-05 | kilogram | ecoinvent-391-cutoff | passive-component | GLO | technosphere | 0 | (Unknown) | (Unknown) | (Unknown) | (Unknown) | (Unknown)
market for capacitor, for surface-mounting | PINHD-1X3 (CT1 CT2 CT3) | 3e-05 | kilogram | ecoinvent-391-cutoff | passive-component | GLO | technosphere | 0 | (Unknown) | (Unknown) | (Unknown) | (Unknown) | (Unknown)
market for liquid crystal display, unmounted | DISPLAY-OLED-128X64-I2C1.3_BIS (D1) | 0.005 | kilogram | ecoinvent-391-cutoff | active-component | GLO | technosphere | 0 | (Unknown) | (Unknown) | (Unknown) | (Unknown) | (Unknown)
market for diode | CGRM400-G (D2 D3) | 2e-05 | kilogram | ecoinvent-391-cutoff | active-component | GLO | technosphere | 0 | (Unknown) | (Unknown) | (Unknown) | (Unknown) | (Unknown)
market for electric connector, peripheral component interconnect buss | U.FL (J1) | 0.001 | kilogram | ecoinvent-391-cutoff | peripherial | GLO | technosphere | 0 | (Unknown) | (Unknown) | (Unknown) | (Unknown) | (Unknown)
market for electric connector, peripheral component interconnect buss | PINHD-1X1 (JP1) | 0.001 | kilogram | ecoinvent-391-cutoff | peripherial | GLO | technosphere | 0 | (Unknown) | (Unknown) | (Unknown) | (Unknown) | (Unknown)
market for electric connector, peripheral component interconnect buss | PINHD-1X6 (JP6) | 0.001 | kilogram | ecoinvent-391-cutoff | peripherial | GLO | technosphere | 0 | (Unknown) | (Unknown) | (Unknown) | (Unknown) | (Unknown)
market for diode | LEDSMT1206 (LED_G0 LED_R0) | 2e-05 | kilogram | ecoinvent-391-cutoff | active-component | GLO | technosphere | 0 | (Unknown) | (Unknown) | (Unknown) | (Unknown) | (Unknown)
market for switch, toggle type | 10-XX (PROG0 RST0) | 0.001 | kilogram | ecoinvent-391-cutoff | electronic-component | GLO | technosphere | 0 | (Unknown) | (Unknown) | (Unknown) | (Unknown) | (Unknown)
market for transistor, surface-mounted | DMN2056 (Q1 Q2) | 0.0001 | kilogram | ecoinvent-391-cutoff | active-component | GLO | technosphere | 0 | (Unknown) | (Unknown) | (Unknown) | (Unknown) | (Unknown)
market for transistor, surface-mounted | IRF?5305R (Q3 Q5) | 0.0001 | kilogram | ecoinvent-391-cutoff | active-component | GLO | technosphere | 0 | (Unknown) | (Unknown) | (Unknown) | (Unknown) | (Unknown)
market for transistor, surface-mounted | BSS131 (Q4 Q6) | 0.0001 | kilogram | ecoinvent-391-cutoff | active-component | GLO | technosphere | 0 | (Unknown) | (Unknown) | (Unknown) | (Unknown) | (Unknown)
market for resistor, surface-mounted | 100k (R1) | 1e-05 | kilogram | ecoinvent-391-cutoff | passive-component | GLO | technosphere | 0 | (Unknown) | (Unknown) | (Unknown) | (Unknown) | (Unknown)
market for resistor, surface-mounted | 10k (R2 R6 R7) | 3e-05 | kilogram | ecoinvent-391-cutoff | passive-component | GLO | technosphere | 0 | (Unknown) | (Unknown) | (Unknown) | (Unknown) | (Unknown)
market for resistor, surface-mounted | 4.7k (R3 R4 R5) | 3e-05 | kilogram | ecoinvent-391-cutoff | passive-component | GLO | technosphere | 0 | (Unknown) | (Unknown) | (Unknown) | (Unknown) | (Unknown)
market for resistor, surface-mounted | 150 (R8) | 1e-05 | kilogram | ecoinvent-391-cutoff | passive-component | GLO | technosphere | 0 | (Unknown) | (Unknown) | (Unknown) | (Unknown) | (Unknown)
market for resistor, surface-mounted | 100 (R9) | 1e-05 | kilogram | ecoinvent-391-cutoff | passive-component | GLO | technosphere | 0 | (Unknown) | (Unknown) | (Unknown) | (Unknown) | (Unknown)
market for sensor | TTP223R_H (TC1 TC2 TC3) | 0.00015 | kilogram | ecoinvent-391-cutoff | electronic-component | GLO | technosphere | 0 | (Unknown) | (Unknown) | (Unknown) | (Unknown) | (Unknown)
market for integrated circuit, logic type | ESP-WROOM-03 (U1) | 0.002 | kilogram | ecoinvent-391-cutoff | active-component | GLO | technosphere | 0 | (Unknown) | (Unknown) | (Unknown) | (Unknown) | (Unknown)
market for integrated circuit, logic type | CARD-µSD-ADAPTERMINI (U2) | 0.0005 | kilogram | ecoinvent-391-cutoff | active-component | GLO | technosphere | 0 | (Unknown) | (Unknown) | (Unknown) | (Unknown) | (Unknown)
market for integrated circuit, logic type | WIRELESS-LORA-RFM95W#SMD (U3) | 0.0005 | kilogram | ecoinvent-391-cutoff | active-component | GLO | technosphere | 0 | (Unknown) | (Unknown) | (Unknown) | (Unknown) | (Unknown)
market for integrated circuit, logic type | MIC5239S (U4) | 0.0005 | kilogram | ecoinvent-391-cutoff | active-component | GLO | technosphere | 0 | (Unknown) | (Unknown) | (Unknown) | (Unknown) | (Unknown)
market for integrated circuit, logic type | DC-DC-STEP-DOWN-LM2596SH (U5) | 0.0005 | kilogram | ecoinvent-391-cutoff | active-component | GLO | technosphere | 0 | (Unknown) | (Unknown) | (Unknown) | (Unknown) | (Unknown)
market for printed wiring board, surface mounted, unmounted | PCB Board | 0.02 | kilogram | ecoinvent-391-cutoff | electronic-component | GLO | technosphere | 0 | (Unknown) | (Unknown) | (Unknown) | (Unknown) | (Unknown)

Sheet: Lignes_capteur
Activity | Lignes de Capteurs
code | Lignes-de-Capteurs
Exchanges
name | alt-name | amount | unit | database | categories | location | type | uncertainty type | loc | scale | shape | minimum | maximum
Lignes de Capteurs |  | 1 | unit | ESOS-Formation |  | GLO | production | 0 | (Unknown) | (Unknown) | (Unknown) | (Unknown) | (Unknown)
market for sensor | Dallas DS18B20 (6 units) | 0.003 | kilogram | ecoinvent-391-cutoff | electronic-component | GLO | technosphere | 0 | (Unknown) | (Unknown) | (Unknown) | (Unknown) | (Unknown)
market for wire, copper | Câblage cuivre capteurs (4.2m, 1.5mm ext) | 0.01892 | kilogram | ecoinvent-391-cutoff | raw-material | GLO | technosphere | 0 | (Unknown) | (Unknown) | (Unknown) | (Unknown) | (Unknown)
market for polyvinylchloride, bulk | Isolant PVC capteurs (4.2m) | 0.0069 | kilogram | ecoinvent-391-cutoff | plastics | GLO | technosphere | 0 | (Unknown) | (Unknown) | (Unknown) | (Unknown) | (Unknown)
market for polyolefin | Gaine thermo capteurs (12x2cm) | 0.00048 | kilogram | ecoinvent-391-cutoff | plastics | GLO | technosphere | 0 | (Unknown) | (Unknown) | (Unknown) | (Unknown) | (Unknown)
market for sensor | Capteur supplémentaire (1 unit) | 0.0005 | kilogram | ecoinvent-391-cutoff | electronic-component | GLO | technosphere | 0 | (Unknown) | (Unknown) | (Unknown) | (Unknown) | (Unknown)
market for wire, copper | Câblage cuivre capteur sup. (1.5m, 1.0mm ext) | 0.00264 | kilogram | ecoinvent-391-cutoff | raw-material | GLO | technosphere | 0 | (Unknown) | (Unknown) | (Unknown) | (Unknown) | (Unknown)
market for polyvinylchloride, bulk | Isolant PVC capteur sup. (1.5m) | 0.00115 | kilogram | ecoinvent-391-cutoff | plastics | GLO | technosphere | 0 | (Unknown) | (Unknown) | (Unknown) | (Unknown) | (Unknown)
market for polyolefin | Gaine thermo capteur sup. (3x2cm) | 0.00012 | kilogram | ecoinvent-391-cutoff | plastics | GLO | technosphere | 0 | (Unknown) | (Unknown) | (Unknown) | (Unknown) | (Unknown)

Sheet: Ligne_ventilateur
Activity | Ligne des Ventilateurs
code | Ligne-des-Ventilateurs
Exchanges
name | alt-name | amount | unit | database | categories | location | type | uncertainty type | loc | scale | shape | minimum | maximum
Ligne des Ventilateurs |  | 1 | unit | ESOS-Formation |  | GLO | production | 0 | (Unknown) | (Unknown) | (Unknown) | (Unknown) | (Unknown)
market for fan | Ventilateur PBT 12V 54mm (6 units) | 0.15 | kilogram | ecoinvent-391-cutoff | electronic-component | GLO | technosphere | 0 | (Unknown) | (Unknown) | (Unknown) | (Unknown) | (Unknown)
market for wire, copper | Câblage cuivre ventilateurs (2.8m, 1.5mm ext) | 0.01261 | kilogram | ecoinvent-391-cutoff | raw-material | GLO | technosphere | 0 | (Unknown) | (Unknown) | (Unknown) | (Unknown) | (Unknown)
market for polyvinylchloride, bulk | Isolant PVC ventilateurs (2.8m) | 0.0046 | kilogram | ecoinvent-391-cutoff | plastics | GLO | technosphere | 0 | (Unknown) | (Unknown) | (Unknown) | (Unknown) | (Unknown)
market for polyolefin | Gaine thermo ventilateurs (8x2cm) | 0.00032 | kilogram | ecoinvent-391-cutoff | plastics | GLO | technosphere | 0 | (Unknown) | (Unknown) | (Unknown) | (Unknown) | (Unknown)

Sheet: Ligne_Chauffe
Activity | Ligne de Chauffe
code | Ligne-de-Chauffe
Exchanges
name | alt-name | amount | unit | database | categories | location | type | uncertainty type | loc | scale | shape | minimum | maximum
Ligne de Chauffe |  | 1 | unit | ESOS-Formation |  | GLO | production | 0 | (Unknown) | (Unknown) | (Unknown) | (Unknown) | (Unknown)
market for passive component | Résistance THS25 1Ohm (8 units) | 0.112 | kilogram | ecoinvent-391-cutoff | electronic-component | GLO | technosphere | 0 | (Unknown) | (Unknown) | (Unknown) | (Unknown) | (Unknown)
market for wire, copper | Câblage cuivre chauffe (2.63m, 3mm ext) | 0.04164 | kilogram | ecoinvent-391-cutoff | raw-material | GLO | technosphere | 0 | (Unknown) | (Unknown) | (Unknown) | (Unknown) | (Unknown)
market for polyvinylchloride, bulk | Isolant PVC chauffe (2.63m) | 0.01813 | kilogram | ecoinvent-391-cutoff | plastics | GLO | technosphere | 0 | (Unknown) | (Unknown) | (Unknown) | (Unknown) | (Unknown)

Sheet: Support
Activity | support
code | support
Exchanges
name | alt-name | amount | unit | database | categories | location | type | uncertainty type | loc | scale | shape | minimum | maximum
support |  | 1 | unit | ESOS-Formation |  | GLO | production | 0 | (Unknown) | (Unknown) | (Unknown) | (Unknown) | (Unknown)
market for sawnwood, softwood, raw | Bois de support | 4 | kilogram | ecoinvent-391-cutoff | raw-material | GLO | technosphere | 0 | (Unknown) | (Unknown) | (Unknown) | (Unknown) | (Unknown)
market for steel, low-alloyed | Acier | 0.5 | kilogram | ecoinvent-391-cutoff | raw-material | GLO | technosphere | 0 | (Unknown) | (Unknown) | (Unknown) | (Unknown) | (Unknown)
market for aluminium, cast alloy | Alu | 0.3 | kilogram | ecoinvent-391-cutoff | raw-material | GLO | technosphere | 0 | (Unknown) | (Unknown) | (Unknown) | (Unknown) | (Unknown)
