Nicolas233004/Projet_elec4/Datasheets/ESP_LoRa_Thermal_V1.62.brd

## EAGLE design Datasheets/ESP_LoRa_Thermal_V1.62.brd (2026-01-20)

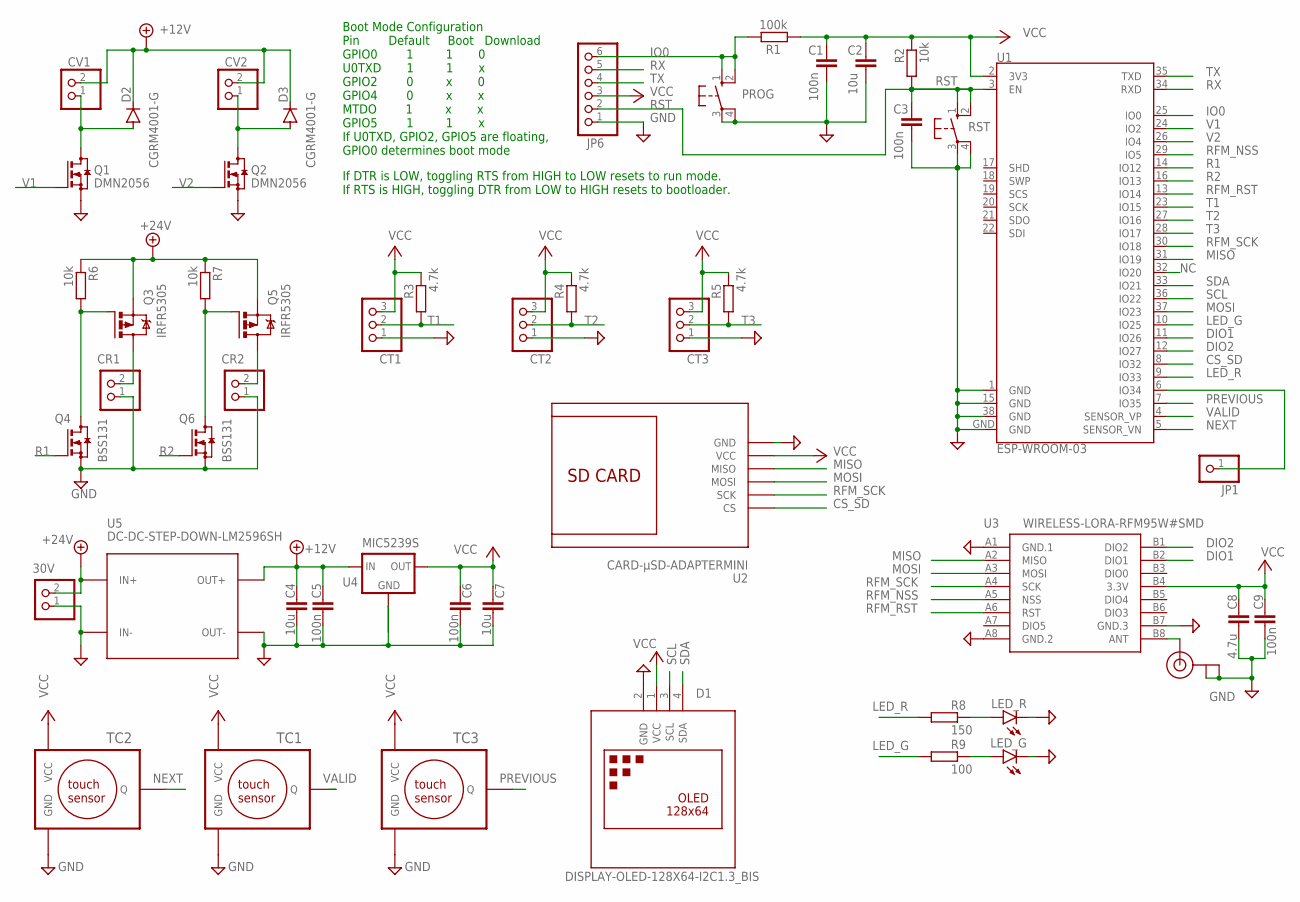
[picture p12: schematic ESP_LoRa_Thermal_V1.62.sch]

Parts:
30V: PINHD-1X2; 1X02
C1, C3, C5, C6, C9: 100n; C1206
C2, C4, C7: 10u; C1206
C8: 4.7u; C1206
CR1, CR2: PINHD-1X2; 1X02
CT1, CT2, CT3: PINHD-1X3; 1X03
CV1, CV2: PINHD-1X2; 1X02
D1: DISPLAY-OLED-128X64-I2C1.3_BIS; DISPLAY-OLED-128X64-1.3-I2C_BIS
D2, D3: CGRM4001-G; SOD-123_MINI-SMA
J1: U.FL
JP1: PINHD-1X1; 1X01
JP6: PINHD-1X6; 1X06
LED_G: LEDSMT1206; 1206
LED_R: LEDSMT1206; 1206
PROG: 10-XX; B3F-10XX
Q1, Q2: DMN2056; SOT23
Q3, Q5: IRFR5305; D-PAK_TO252AA
Q4, Q6: BSS131; SOT23
R1: 100k; R1206
R2, R6, R7: 10k; R1206
R3, R4, R5: 4.7k; R1206
R8: 150; R1206
R9: 100; R1206
RST: 10-XX; B3F-10XX
TC1, TC2, TC3: TTP223R_H; TTP233RED_H
U1: ESP-WROOM-03
U2: CARD-µSD-ADAPTERMINI; CARD-MINI--µSD-READER
U3: WIRELESS-LORA-RFM95W#SMD
U4: MIC5239S; SOT223
U5: DC-DC-STEP-DOWN-LM2596SH; DC-DC-STEP-DOWN-LM2596-SH

Connections:
+12V: C4.1, C5.1, CV1.2, CV2.2, D2.C, D3.C, U4.1 (IN), U5.OUT+
+24V: 30V.2, Q3.3 (S), Q5.3 (S), R6.1, R7.1, U5.IN+
ANT: J1.3 (SIGNAL), U3.B8 (ANT)
CS_SD: U1.8 (IO32), U2.CS
DIO1: U1.11 (IO26), U3.B2 (DIO1)
DIO2: U1.12 (IO27), U3.B1 (DIO2)
GND: 30V.1, C1.2, C2.2, C3.2, C4.2, C5.2, C6.2, C7.2, C8.2, C9.2, CR1.1, CR2.1, CT1.1, CT2.1, CT3.1, D1.2 (GND), J1.1 (GND), J1.2 (GND), JP6.1, LED_G.C, LED_R.C, PROG.3, PROG.4 (P1), Q1.2 (S), Q2.2 (S), Q4.2 (S), Q6.2 (S), RST.3, RST.4 (P1), TC1.P$3 (GND), TC2.P$3 (GND), TC3.P$3 (GND), U1.1 (GND), U1.15 (GND), U1.38 (GND), U1.GND, U2.GND, U3.A1 (GND.1), U3.A8 (GND.2), U3.B7 (GND.3), U4.2 (GND), U4.4 (GND), U5.IN-, U5.OUT-
IO0: JP6.6, PROG.1 (S), PROG.2 (S1), R1.2, U1.25 (IO0)
LED_G: R9.1, U1.10 (IO25)
LED_R: R8.1, U1.9 (IO33)
MISO: U1.31 (IO19), U2.MISO, U3.A2 (MISO)
MOSI: U1.37 (IO23), U2.MOSI, U3.A3 (MOSI)
unnamed: CR2.2, Q5.4 (D)
unnamed: CV1.1, D2.A, Q1.3 (D)
unnamed: CR1.2, Q3.4 (D)
unnamed: CV2.1, D3.A, Q2.3 (D)
unnamed: JP1.1, U1.6 (IO34)
unnamed: LED_R.A, R8.2
unnamed: LED_G.A, R9.2
unnamed: Q3.1 (G), Q4.3 (D), R6.2
unnamed: Q5.1 (G), Q6.3 (D), R7.2
NC: U1.32 (IO20)
NEXT: TC2.P$2 (Q), U1.5 (SENSOR_VN)
PREVIOUS: TC3.P$2 (Q), U1.7 (IO35)
R1: Q4.1 (G), U1.14 (IO12)
R2: Q6.1 (G), U1.16 (IO13)
RFM_NSS: U1.29 (IO5), U3.A5 (NSS)
RFM_RST: U1.13 (IO14), U3.A6 (RST)
RFM_SCK: U1.30 (IO18), U2.SCK, U3.A4 (SCK)
RST: C3.1, JP6.2, R2.1, RST.1 (S), RST.2 (S1), U1.3 (EN)
RX: JP6.5, U1.34 (RXD)
SCL: D1.3 (SCL), U1.36 (IO22)
SDA: D1.4 (SDA), U1.33 (IO21)
T1: CT1.2, R3.1, U1.23 (IO15)
T2: CT2.2, R4.1, U1.27 (IO16)
T3: CT3.2, R5.1, U1.28 (IO17)
TX: JP6.4, U1.35 (TXD)
V1: Q1.1 (G), U1.24 (IO2)
V2: Q2.1 (G), U1.26 (IO4)
VALID: TC1.P$2 (Q), U1.4 (SENSOR_VP)
VCC: C1.1, C2.1, C6.1, C7.1, C8.1, C9.1, CT1.3, CT2.3, CT3.3, D1.1 (VCC), JP6.3, R1.1, R2.2, R3.2, R4.2, R5.2, TC1.P$1 (VCC), TC2.P$1 (VCC), TC3.P$1 (VCC), U1.2 (3V3), U2.VCC, U3.B4 (3.3V), U4.3 (OUT)

Notes on the sheet:
If DTR is LOW, toggling RTS from HIGH to LOW resets to run mode. If RTS is HIGH, toggling DTR from LOW to HIGH resets to bootloader.
Boot Mode Configuration Pin Default Boot Download GPIO0 1 1 0 U0TXD 1 1 x GPIO2 0 x 0 GPIO4 0 x x MTDO 1 x x GPIO5 1 1 x If U0TXD, GPIO2, GPIO5 are floating, GPIO0 determines boot mode

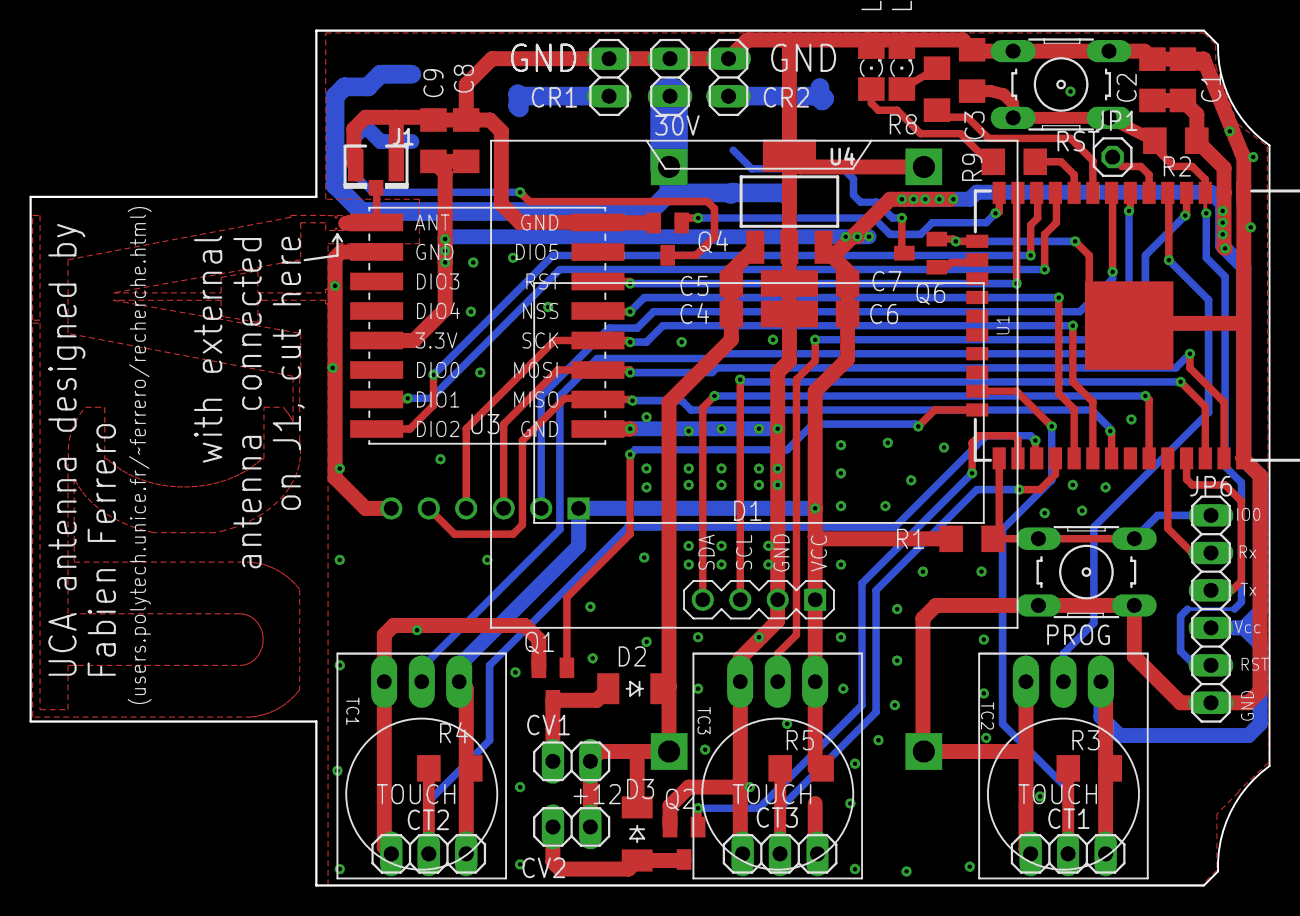
[picture p13: board ESP_LoRa_Thermal_V1.62.brd from above]

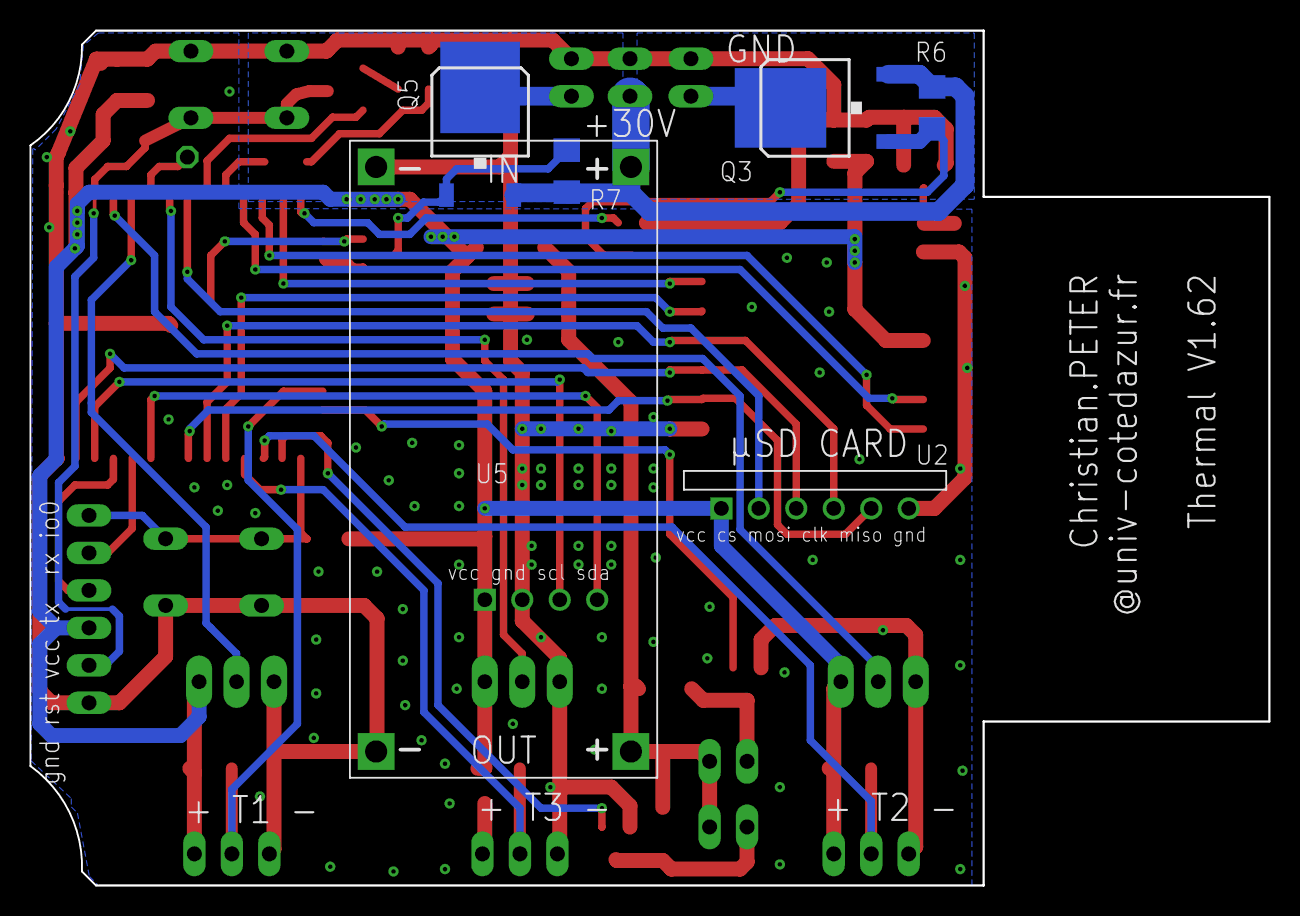
[picture p14: board ESP_LoRa_Thermal_V1.62.brd from below]

Board: 2 copper layers, 84.0 x 57.9 mm, 50 parts (6 on the bottom side), 40 nets.
