Nicolas233004/Projet_elec4/(commit log)

2025-12-11 Add session report for Séance 4
    Document the activities and progress made during the fourth session, including PCB modifications and preparations for future tests.
2025-12-11 Séance 6
    Document the objectives, proceedings, and conclusions of the sixth session regarding the heated beehive project, including issues with the circuit and components.
2026-01-20 plans carte
    [ESP_LoRa_Thermal_V1.62.brd, ESP_LoRa_Thermal_V1.62.sch]
2026-02-19 Create Rapport de Séance 11
2026-02-19 Rename Rapport de Séance 11 to Rapport de Séance 11.md
2026-02-19 Rename Rapport de Séance 11.md to Rapport Séance 11.md
2026-03-17 Add report for Séance 13 on heating system project
    Document the objectives, process, and results of Séance 13 regarding the heating system for beehives, including modifications made to the filtering cell and ongoing issues.
2026-03-17 Add report for sessions 14 and 15 of beehive project
    Document the objectives, process, and outcomes of sessions 14 and 15 for the beehive heating project, including issues resolved and new sensor line added.
2026-04-03 Add session 16 report on thermal monitoring integration
    This report details the objectives, software updates, and conclusions of session 16, focusing on the integration of internal hive temperature monitoring.
2026-04-17 Ajout fichier excel
    [ESP_LoRa_Thermal_V1.62.csv]
2026-04-17 Analyse toit chauffant
    [Toit_chauffant.xlsx]
2026-04-24 ajout Rapport fin de projet
2026-04-24 modif Rapport fin de projet
